ZyntelliTech/Solidyne-SAM-BBG/layouts/Screenshot 2026-08-22 121604.png

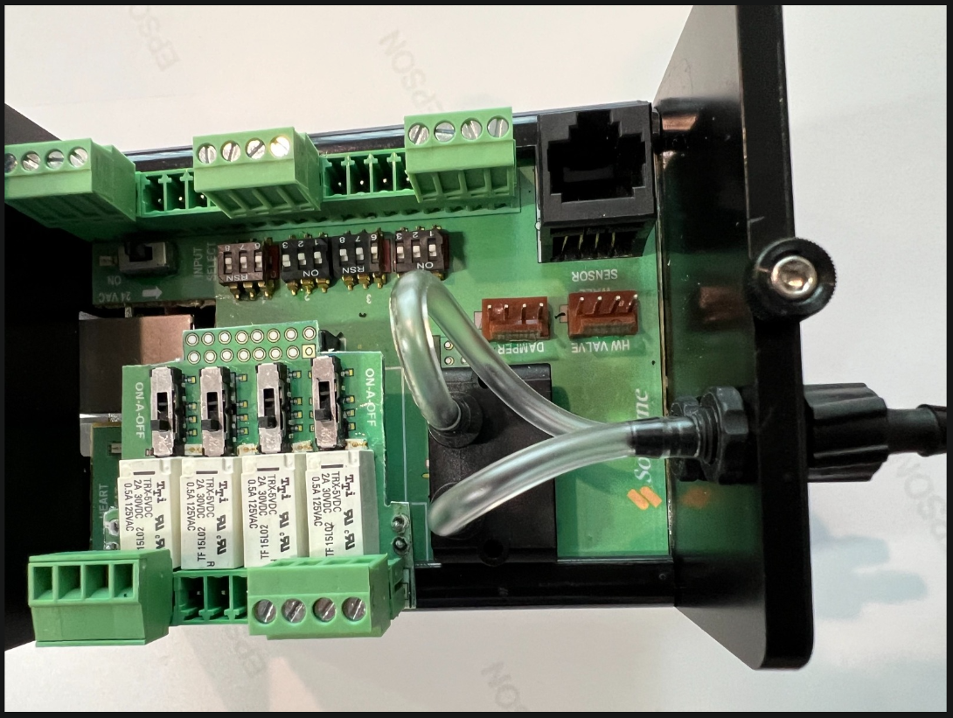
layouts/Screenshot 2026-08-22 121604.png
