ZyntelliTech/Solidyne-SAM-BBG/layouts/comment from Baha 9-17-2026.pdf

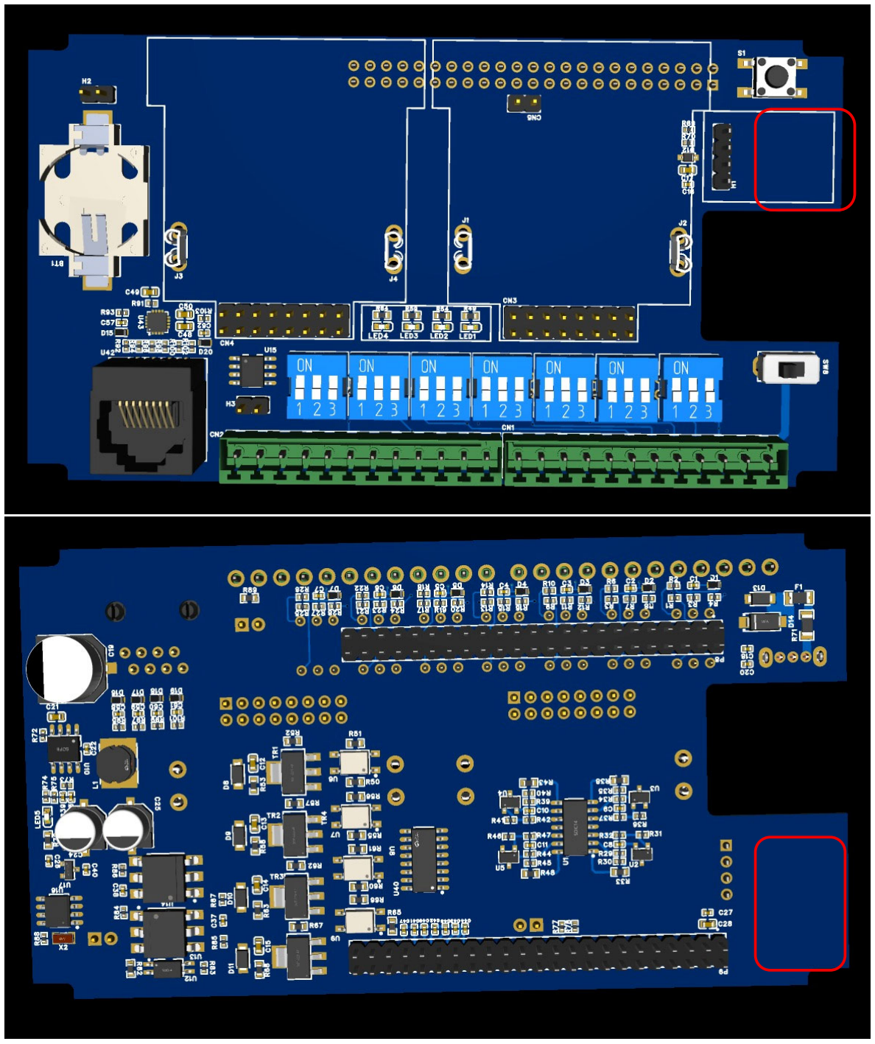
[picture p3: figure]
