ZyntelliTech/Solidyne-SAM-BBG/image/SAM-25-REV.png

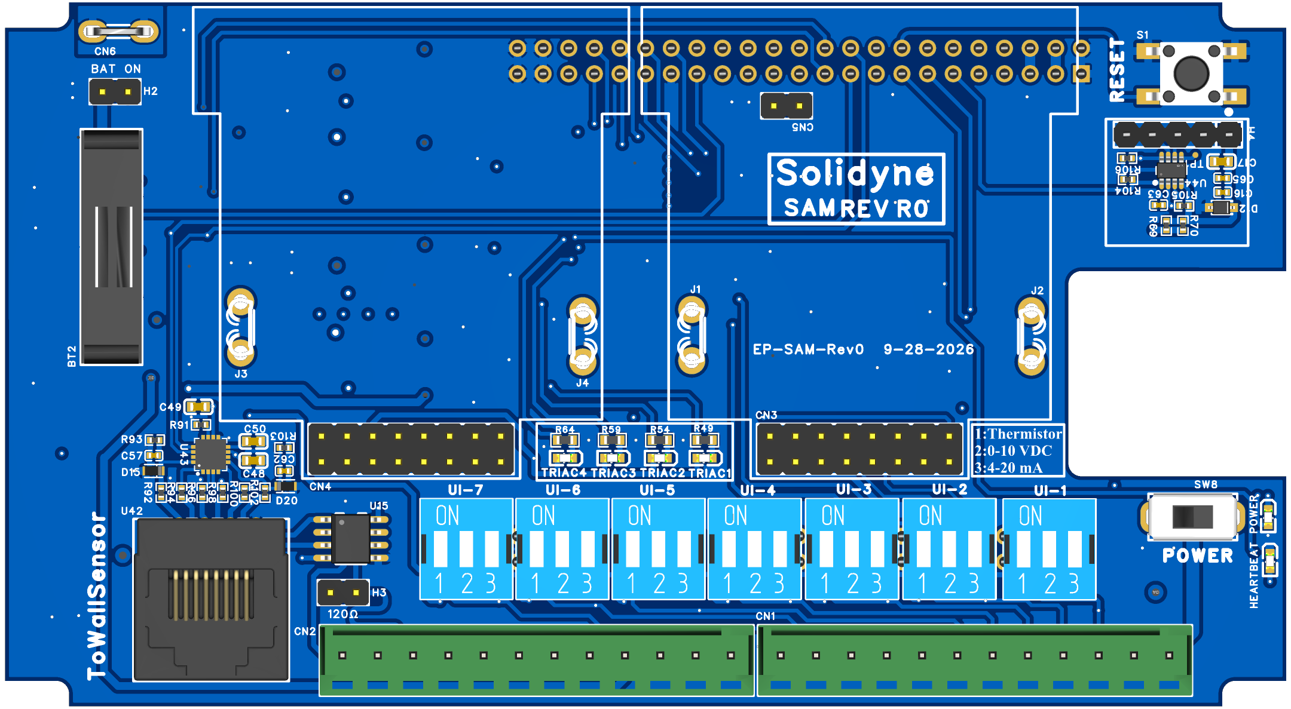
image/SAM-25-REV.png
