ZyntelliTech/Solidyne-SAM-BBG/image/SAM-VAV.png

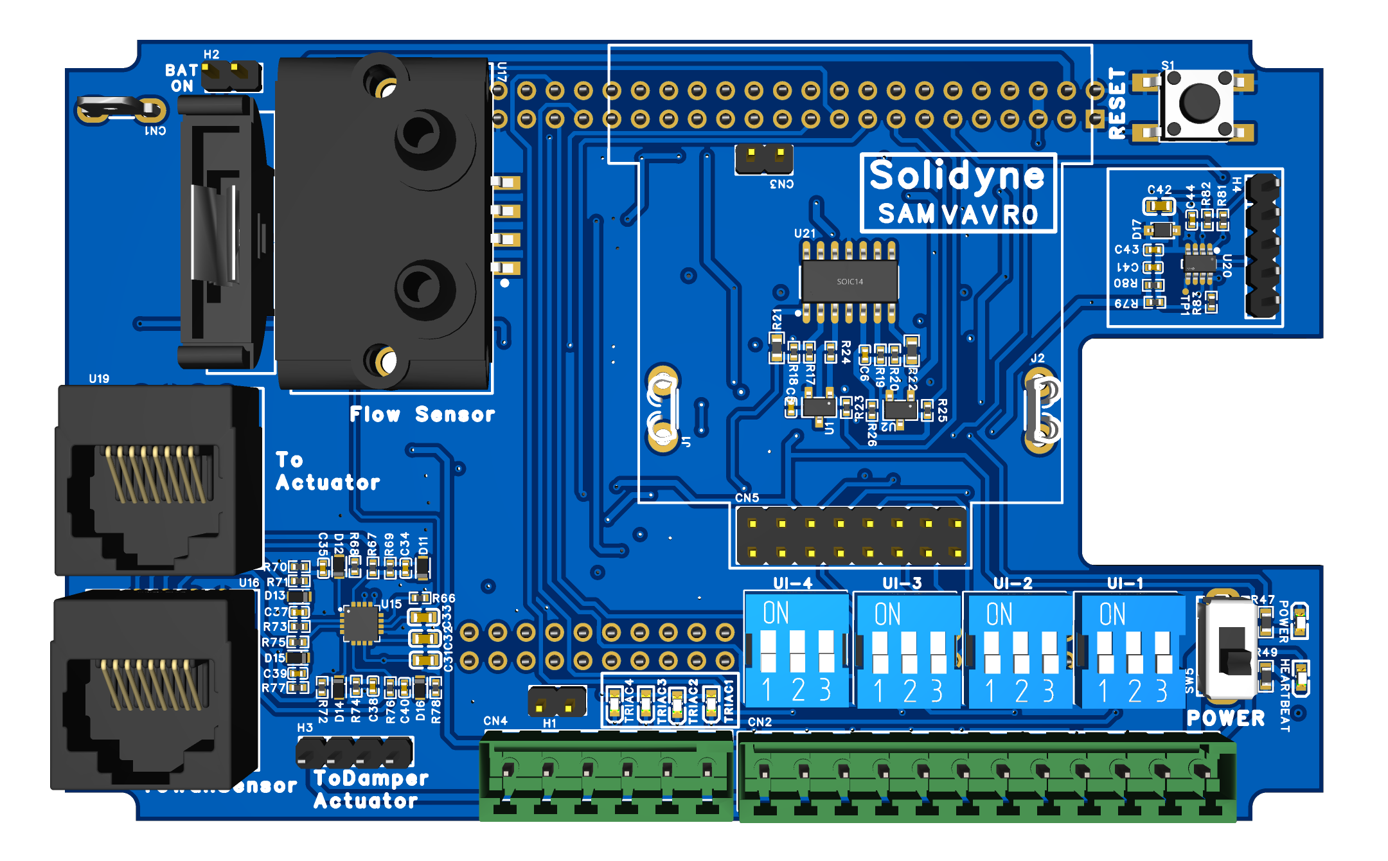
image/SAM-VAV.png
