ZyntelliTech/Solidyne-SAM-BBG/layouts/SAM-25-1.jpeg

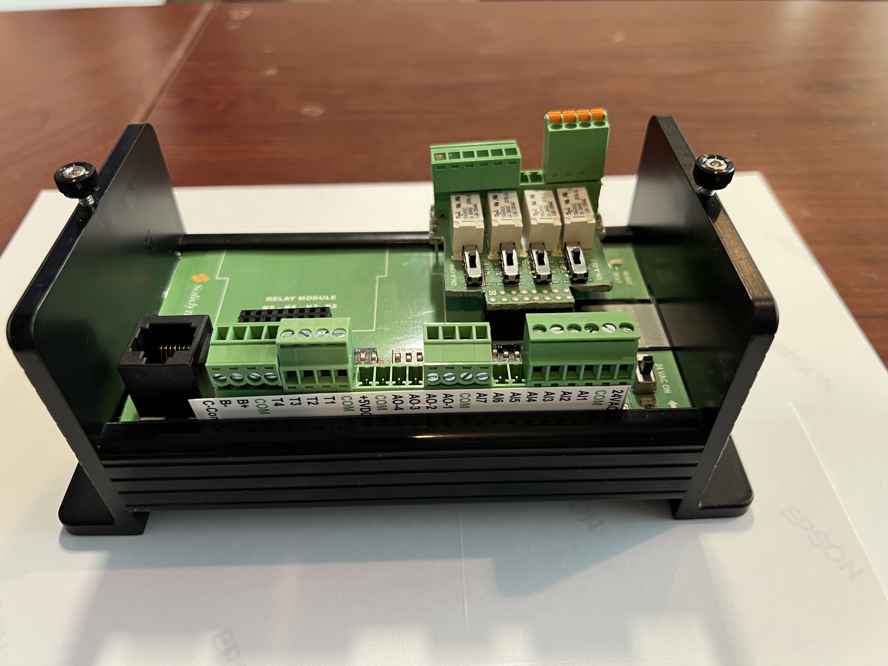
layouts/SAM-25-1.jpeg
