ZyntelliTech/Solidyne-SAM-BBG/layouts/SAM-25-2.jpeg

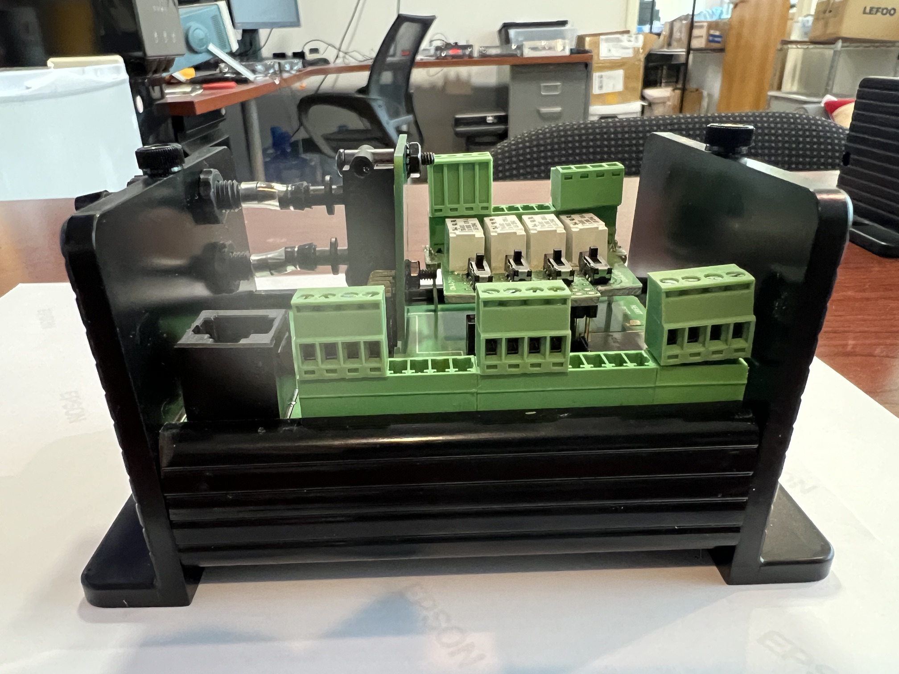
layouts/SAM-25-2.jpeg
