ZyntelliTech/Solidyne-SAM-BBG/layouts/SAM-25.png

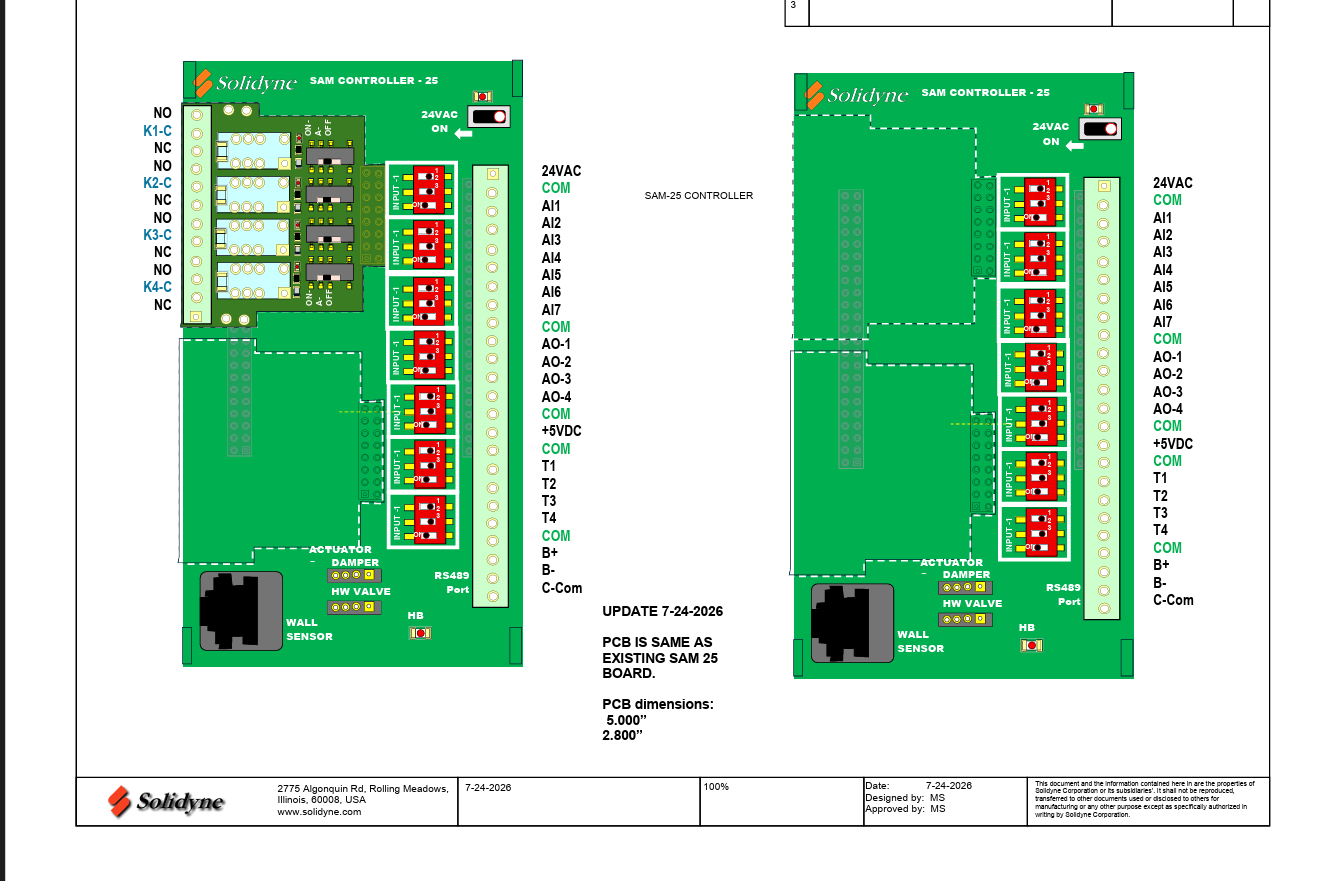
layouts/SAM-25.png
