ZyntelliTech/Solidyne-SAM-BBG/layouts/SAM-VAV-1.jpeg

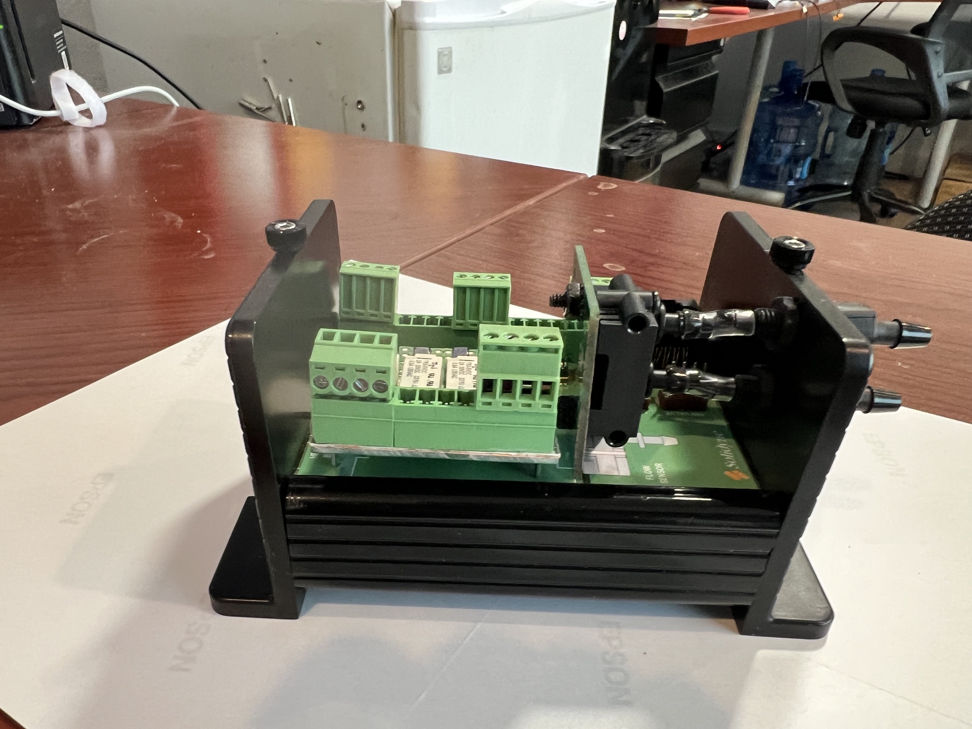
layouts/SAM-VAV-1.jpeg
