ZyntelliTech/Solidyne-SAM-BBG/layouts/SAM-VAV-2.jpeg

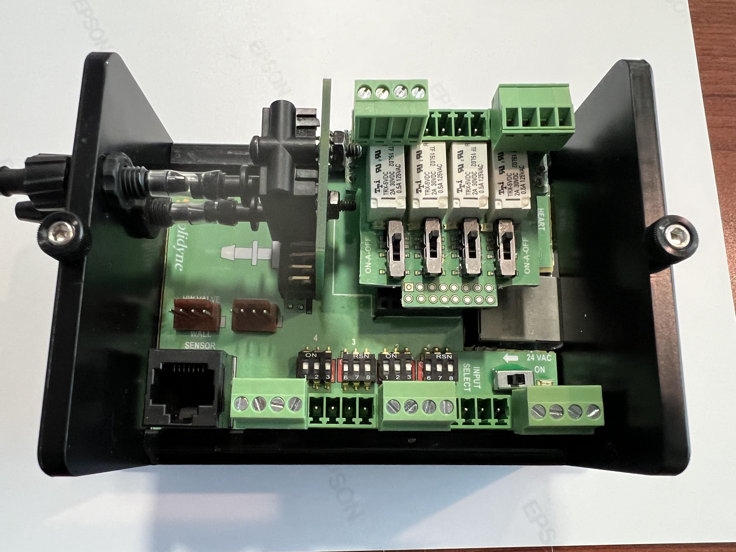
layouts/SAM-VAV-2.jpeg
