ZyntelliTech/Solidyne-SAM-BBG/layouts/SAM-VAV-3.jpeg

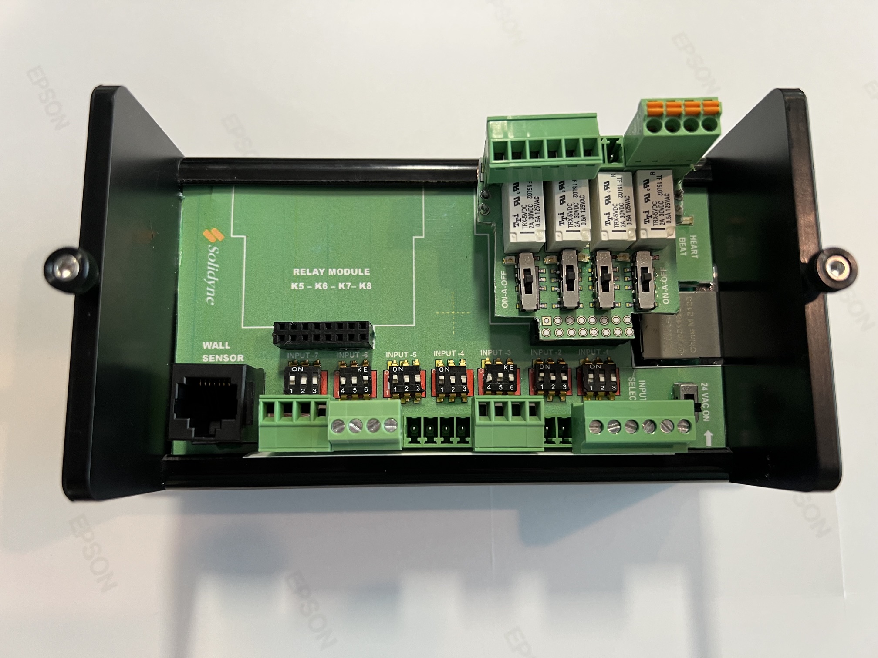
layouts/SAM-VAV-3.jpeg
