ZyntelliTech/Solidyne-SAM-BBG/layouts/SAM_VAV.png

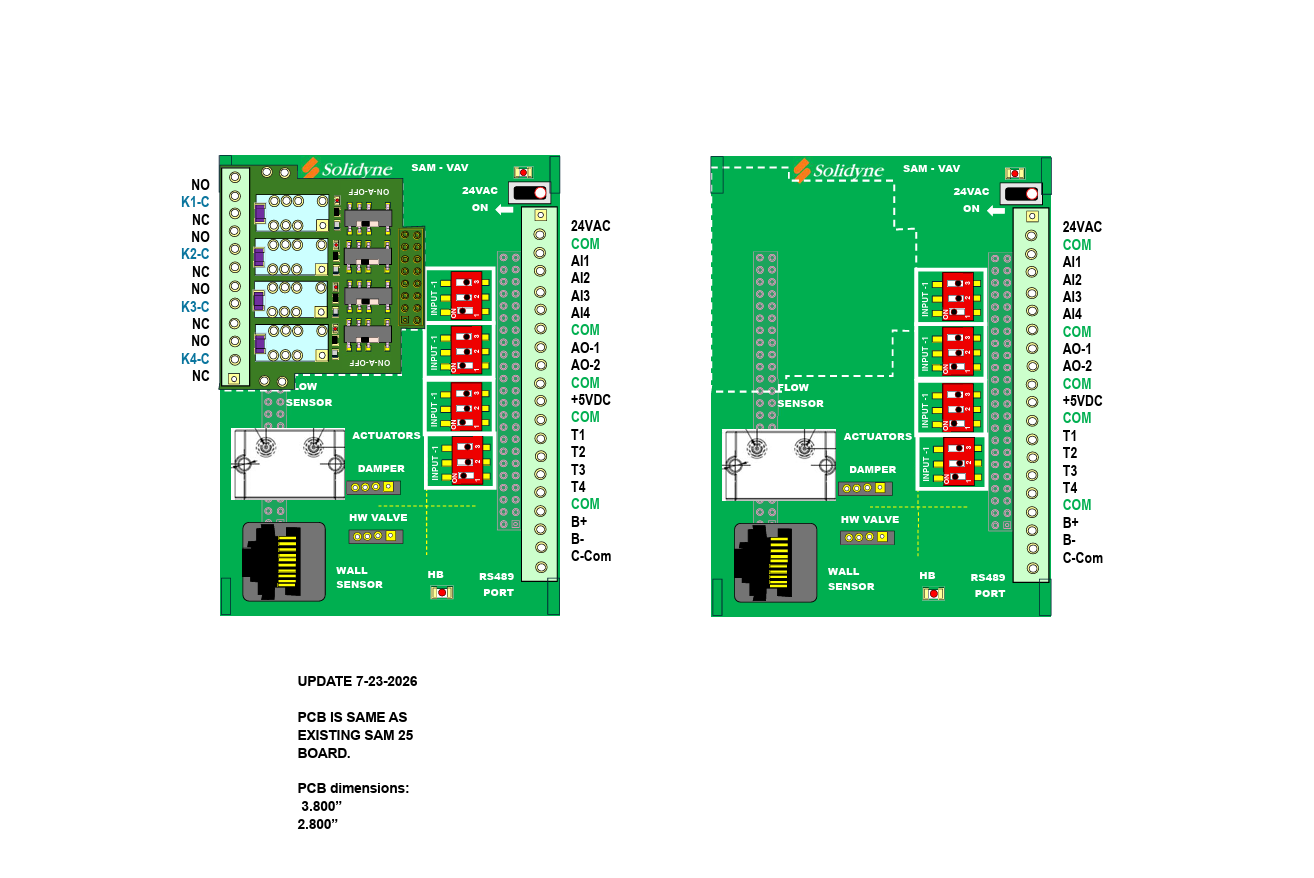
layouts/SAM_VAV.png
