ZyntelliTech/Solidyne-SAM-BBG/layouts/Screenshot 2026-08-22 121533.png

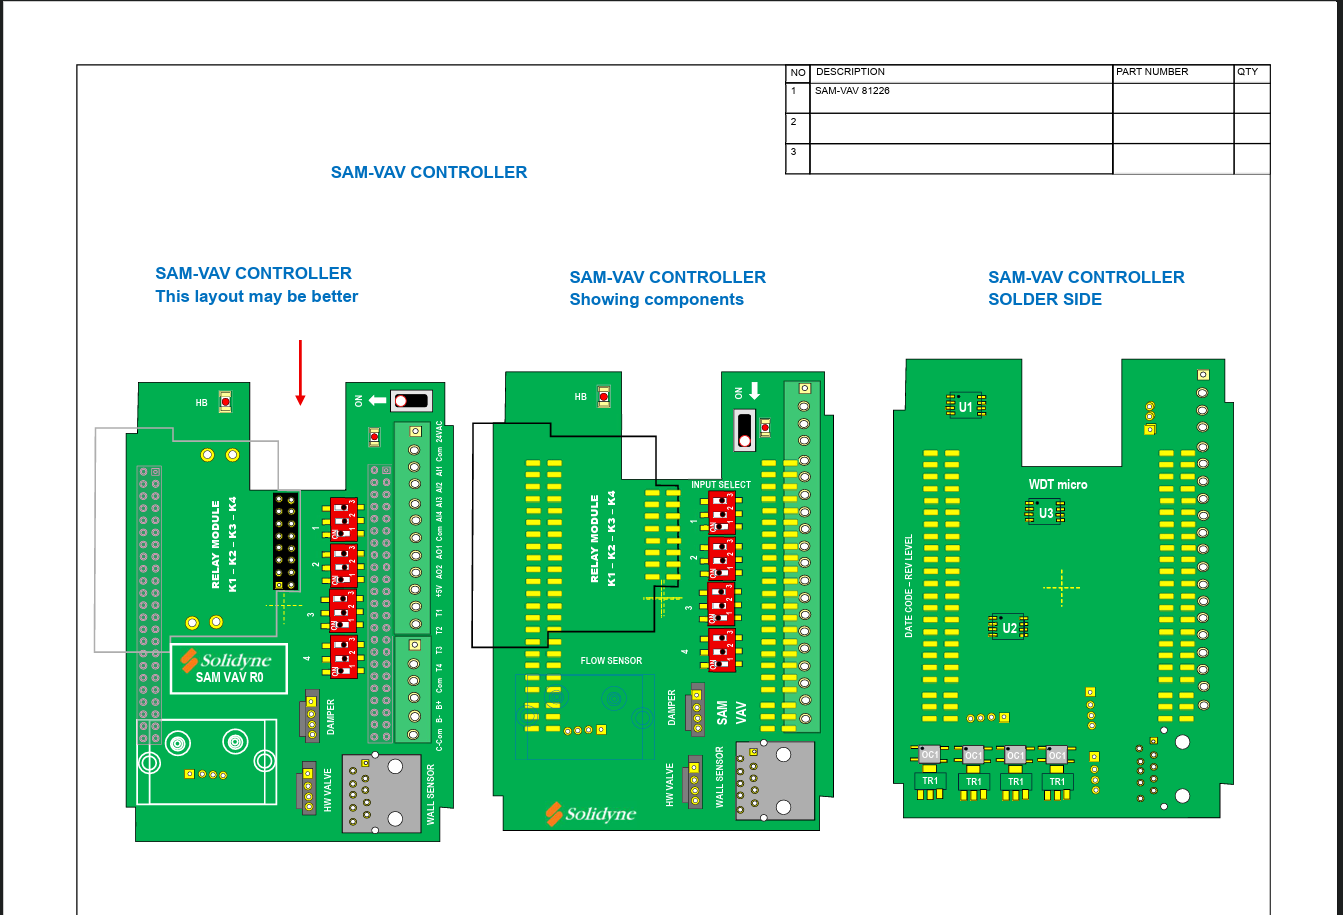
layouts/Screenshot 2026-08-22 121533.png
