ZyntelliTech/Solidyne-SAM-BBG/layouts/Screenshot 2026-08-22 121612.png

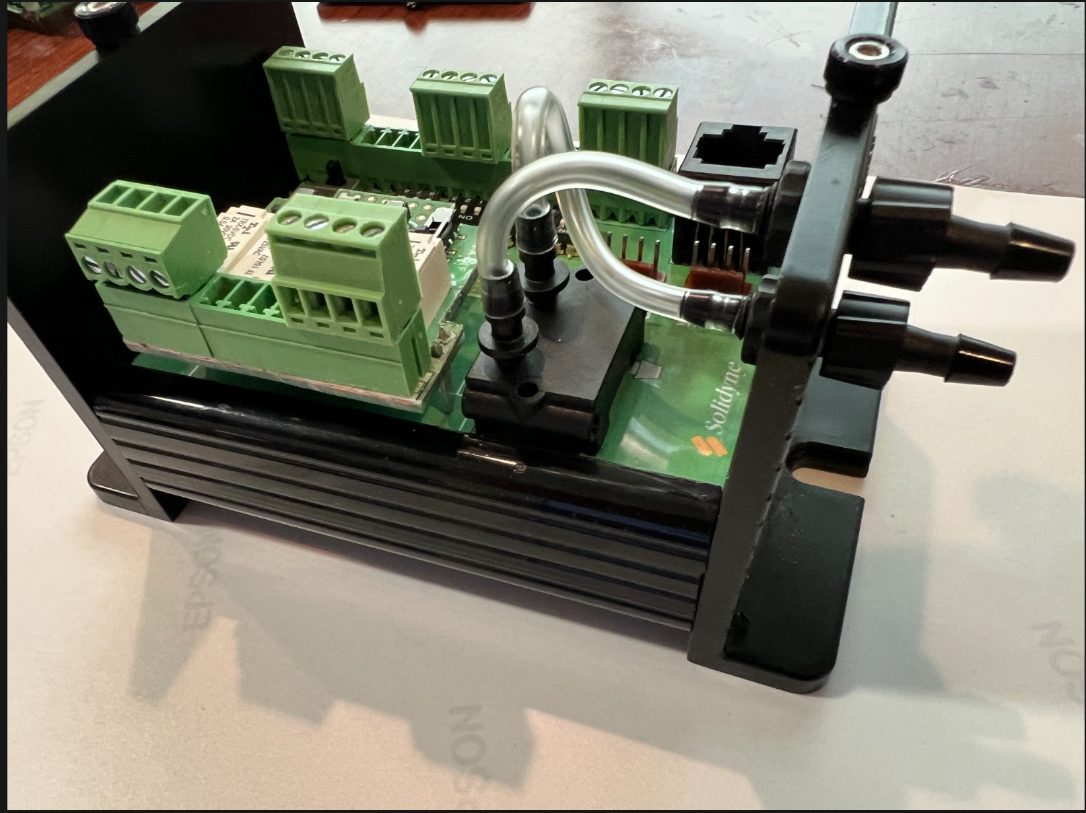
layouts/Screenshot 2026-08-22 121612.png
