ZyntelliTech/Solidyne-SAM-BBG/WDT_SAM_Kicad/WDT_SAM_bom.xlsx

Comment | Designator | Footprint | JLCPCB Part #（optional）
100nF | C1,C3 | Capacitor_SMD:C_0603_1608Metric_Pad1.08x0.95mm_HandSolder | C1590
2.2uF | C2 | Capacitor_SMD:C_0603_1608Metric_Pad1.08x0.95mm_HandSolder | C43922
Conn_01x04_Pin | J1 | Connector_PinHeader_2.54mm:PinHeader_1x04_P2.54mm_Vertical
Conn_01x05_Pin | J2 | Connector_PinHeader_2.54mm:PinHeader_1x05_P2.54mm_Vertical_SMD_Pin1Left | C5160788
33K | R1,R2,R3 | Resistor_SMD:R_0603_1608Metric_Pad0.98x0.95mm_HandSolder | C4216
TestPoint | TP1 | TestPoint:TestPoint_Pad_1.0x1.0mm
MSPM0C1103SDDFR | U2 | footprints:DDF0008A-IPC_A | C35962001
