ZyntelliTech/Solidyne-SAM-BBG/Fab/Relay/BOM_Relay_RelayPCB.xlsx

No. | Quantity | Comment | Designator | Footprint | Value | Manufacturer Part | Manufacturer | Supplier Part | Supplier
1 | 2 | G480-08-2T | CN2,CN3 | TH-2_L6.4-W0.8-P5.08 |  | G480-08-2T | SAMZO(三佐) | C39833011 | LCSC
2 | 1 | PZ254V-12-16P | CN4 | HDR-TH_16P-P2.54-V-M-R2-C8-S2.54 |  | PZ254V-12-16P | XFCN(兴飞) | C492425 | LCSC
3 | 4 | SMAJ60CA | D1,D2,D3,D4 | SMA_L4.4-W2.6-LS5.0-BI |  | SMAJ60CA | Littelfuse(美国力特) | C151247 | LCSC
4 | 4 | G6S-2 DC5 | K1,K2,K3,K4 | RELAY-TH_G6S-2-X |  | G6S-2 DC5 | OMRON(欧姆龙) | C32776 | LCSC
5 | 4 | 204-10SDRD/S530-A3/F182-68 | LED1,LED2,LED3,LED4 | LED-TH_BD4.0-P2.50-RD |  | 204-10SDRD/S530-A3/F182-68 | EVERLIGHT(亿光) | C473831 | LCSC
6 | 4 | 470Ω | R1,R2,R3,R4 | R0402 | 470Ω | RC0402JR-07470RL | YAGEO(国巨) | C114949 | LCSC
7 | 4 | MSS23C02G2-KC 125 | SW1,SW2,SW3,SW4 | SW-SMD_MSS23C02G2-KC |  | MSS23C02G2-KC 125 | SHOU HAN(首韩) | C2858292 | LCSC
8 | 1 | KF2EDGV-3.5-12P | TB-1 | CONN-TH_12P-P3.50_KF2EDGV-3.5-12P |  | KF2EDGV-3.5-12P | KEFA(科发) | C441319 | LCSC
9 | 4 | CDBU00340-HF | U1,U2,U3,U4 | SOD-523F_L1.7-W0.9-LS1.7-RD |  | CDBU00340-HF | Comchip(典琦) | C2886021 | LCSC
10 | 1 | ULN2003ADR | U5 | SOIC-16_L9.9-W3.9-P1.27-LS6.0-BL |  | ULN2003ADR | TI(德州仪器) | C7512 | LCSC
