ZyntelliTech/Solidyne-SAM-BBG/Fab/SAM-VAV/BOM_SAM-VAV_PCB.xlsx

No. | Quantity | Comment | Designator | Footprint | Value | Manufacturer Part | Manufacturer | Supplier Part | Supplier
1 | 1 | BS-05-A1BJ001 | BT1 | BAT-TH_BS-05-A1BJ001 |  | BS-05-A1BJ001 | MYOUNG(美阳) | C964752 | LCSC
2 | 24 | 100nF | C1,C2,C3,C4,C11,C14,C19,C22,C24,C25,C26,C27,C28,C29,C30,C34,C35,C36,C37,C38,C39,C40,C41,C44 | C0402 | 100nF | CL05B104KB54PNC | SAMSUNG(三星) | C307331 | LCSC
3 | 2 | 10uF | C5,C6 | C0402 | 10uF | CL05A106MP5NUNC | SAMSUNG(三星) | C315248 | LCSC
4 | 4 | 10nF | C7,C8,C9,C10 | C0603 | 10nF | CC0603JRX7R9BB103 | YAGEO(国巨) | C115056 | LCSC
5 | 1 | 220nF | C12 | C0402 | 220nF | GRM155R61H224KE01D | muRata(村田) | C5159775 | LCSC
6 | 1 | 330uF | C13 | CAP-SMD_BD10.0-L10.3-W10.3-LS11.3-FD | 330uF | RVT1H331M1010 | ROQANG(容强) | C3032175 | LCSC
7 | 5 | 1uF | C15,C31,C32,C33,C42 | C0603 | 1uF | CL10A105KB8NNNC | SAMSUNG(三星) | C15849 | LCSC
8 | 1 | 47pF | C16 | C0402 | 47pF | 0402CG470J500NT | FH(风华) | C1567 | LCSC
9 | 2 | 220uF | C17,C18 | CAP-SMD_BD6.3-L6.6-W6.6-FD | 220uF | RVT1A221M0605 | ROQANG(容强) | C72494 | LCSC
10 | 1 | 3.3nF | C20 | C0402 | 3.3nF | CC0402KRX7R9BB332 | YAGEO(国巨) | C107028 | LCSC
11 | 2 | 2.2uF | C21,C43 | C0402 | 2.2uF | CL05A225MQ5NSNC | SAMSUNG(三星) | C12530 | LCSC
12 | 1 | 10uF | C23 | C0603 | 10uF | CL10A106KP8NNNC | SAMSUNG(三星) | C19702 | LCSC
13 | 1 | G480-08-2T | CN1 | TH-2_L6.4-W0.8-P5.08 |  | G480-08-2T | SAMZO(三佐) | C39833011 | LCSC
14 | 1 | KF2EDGV-3.5-12P | CN2 | CONN-TH_12P-P3.50_KF2EDGV-3.5-12P |  | KF2EDGV-3.5-12P | KEFA(科发) | C441319 | LCSC
15 | 1 | JP2 | CN3 | HDR-TH_2P-P2.54-V-M |  | JP2 | XFCN(兴飞) | C492401 | LCSC
16 | 1 | KF2EDGV-3.5-6P | CN4 | CONN-TH_6P-P3.50_KF2EDGV-3.5-6P |  | KF2EDGV-3.5-6P | KEFA(科发) | C441325 | LCSC
17 | 1 | PZ254V-12-16P | CN5 | HDR-TH_16P-P2.54-V-M-R2-C8-S2.54 |  | PZ254V-12-16P | XFCN(兴飞) | C492425 | LCSC
18 | 10 | CDBU00340-HF | D1,D2,D3,D4,D11,D12,D13,D14,D15,D16 | SOD-523F_L1.7-W0.9-LS1.7-RD |  | CDBU00340-HF | Comchip(典琦) | C2886021 | LCSC
19 | 5 | SMF60CA | D5,D6,D7,D8,D10 | SOD-123FL_L2.8-W1.8-LS3.7-BI |  | SMF60CA | R+O(宏嘉诚) | C41376092 | LCSC
20 | 1 | ES1B-13-F | D9 | SMA_L4.4-W2.8-LS5.4-RD |  | ES1B-13-F | DIODES(美台) | C106868 | LCSC
21 | 1 | MM3Z3V3ST1G | D17 | SOD-323_L1.7-W1.3-LS2.5-RD |  | MM3Z3V3ST1G | onsemi(安森美) | C182011 | LCSC
22 | 1 | 0466.500NRHF | F1 | F1206 |  | 0466.500NRHF | Littelfuse(美国力特) | C151133 | LCSC
23 | 2 | PZ254V-11-02P | H1,H2 | HDR-TH_2P-P2.54-V-M |  | PZ254V-11-02P | XFCN(兴飞) | C492401 | LCSC
24 | 1 | TEMP SENSOR | H3 | HDR-TH_4P-P2.54-V-M |  | TEMP SENSOR | XFCN(兴飞) | C2691448 | LCSC
25 | 1 | PZ254V-11-05P | H4 | HDR-TH_5P-P2.54-V-M |  | PZ254V-11-05P | XFCN(兴飞) | C492404 | LCSC
26 | 6 | KT-0603R | HEARTBEAT,POWER,TRIAC1,TRIAC2,TRIAC3,TRIAC4 | LED-SMD_L1.6-W0.8-R-RD |  | KT-0603R | KENTO | C2286 | LCSC
27 | 2 | 3551 | J1,J2 | CONN-TH_3551 |  | 3551 | Keystone | C238112 | LCSC
28 | 1 | 6.8uH | L1 | IND-SMD_L5.8-W5.2 | 6.8uH | CY54-6.8UH | SHOU HAN(首韩) | C2929430 | LCSC
29 | 2 | X6521WV-2x23H-C60D30 | P8,P9 | HDR-TH_46P-2.54-V-M-R2-C23-S2.54 |  | X6521WV-2x23H-C60D30 | XKB Connection(中国星坤) | C725895 | LCSC
30 | 16 | 10kΩ | R1,R2,R5,R6,R9,R10,R13,R14,R17,R19,R67,R68,R71,R72,R75,R76 | R0402 | 10kΩ | 0402WGF1002TCE | UNI-ROYAL(厚声) | C25744 | LCSC
31 | 4 | 90.9Ω | R4,R8,R12,R16 | R0402 | 90.9Ω | 0402WGF909JTCE | UNI-ROYAL(厚声) | C129693 | LCSC
32 | 2 | 71.5kΩ | R18,R20 | R0402 | 71.5kΩ | RT0402BRD0771K5L | YAGEO(国巨) | C852906 | LCSC
33 | 2 | 50Ω | R21,R22 | R0603 | 50Ω | RT0603BRE0750RL | YAGEO(国巨) | C849792 | LCSC
34 | 9 | 1kΩ | R23,R25,R57,R58,R59,R61,R63,R64,R65 | R0402 | 1kΩ | 0402WGF1001TCE | UNI-ROYAL(厚声) | C11702 | LCSC
35 | 3 | 100kΩ | R24,R26,R66 | R0402 | 100kΩ | 0402WGF1003TCE | UNI-ROYAL(厚声) | C25741 | LCSC
36 | 4 | 330Ω | R27,R28,R37,R38 | R0603 | 330Ω | 0603WAF3300T5E | UNI-ROYAL(厚声) | C23138 | LCSC
37 | 7 | 470Ω | R29,R30,R39,R40,R47,R49,R56 | R0603 | 470Ω | 0603WAF4700T5E | UNI-ROYAL(厚声) | C23179 | LCSC
38 | 4 | 220Ω | R31,R32,R41,R42 | R0603 | 220Ω | 0603WAF2200T5E | UNI-ROYAL(厚声) | C22962 | LCSC
39 | 4 | 1kΩ | R33,R35,R43,R45 | R0603 | 1kΩ | 0603WAF1001T5E | UNI-ROYAL(厚声) | C21190 | LCSC
40 | 4 | 100Ω | R34,R36,R44,R46 | R0603 | 100Ω | 0603WAF1000T5E | UNI-ROYAL(厚声) | C22775 | LCSC
41 | 1 | 0Ω | R48 | R1206 | 0Ω | 1206W4F0000T5E | UNI-ROYAL(厚声) | C17888 | LCSC
42 | 1 | 115kΩ | R50 | R0402 | 115kΩ | RC0402FR-07115KL | YAGEO(国巨) | C273341 | LCSC
43 | 1 | 14kΩ | R51 | R0402 | 14kΩ | RC0402FR-0714KL | YAGEO(国巨) | C327372 | LCSC
44 | 1 | 200kΩ | R52 | R0402 | 200kΩ | 0402WGF2003TCE | UNI-ROYAL(厚声) | C25764 | LCSC
45 | 1 | 22kΩ | R53 | R0402 | 22kΩ | 0402WGF2202TCE | UNI-ROYAL(厚声) | C25768 | LCSC
46 | 9 | 4.7kΩ | R54,R55,R62,R69,R70,R73,R74,R77,R78 | R0402 | 4.7kΩ | 0402WGF4701TCE | UNI-ROYAL(厚声) | C25900 | LCSC
47 | 1 | 120Ω | R60 | R0603 | 120Ω | 0603WAF1200T5E | UNI-ROYAL(厚声) | C22787 | LCSC
48 | 2 | 6.8kΩ | R79,R80 | R0402 | 6.8kΩ | RC0402FR-076K8L | YAGEO(国巨) | C93940 | LCSC
49 | 3 | 33kΩ | R81,R82,R83 | R0402 | 33kΩ | FRC0402F3302TS | FOJAN(富捷) | C2909350 | LCSC
50 | 4 | 2.2kΩ | R162,R163,R164,R165 | R0402 | 2.2kΩ | 0402WGF2201TCE | UNI-ROYAL(厚声) | C25879 | LCSC
51 | 1 | RESET | S1 | KEY-SMD_4P-L6.0-W6.0-P4.50-LS8.6 |  | RESET | Megastar(兆星) | C7470153 | LCSC
52 | 1 | SS12D07VG4 087 | SW5 | SW-TH_SS12D07VG4 |  | SS12D07VG4 087 | SHOU HAN(首韩) | C2939726 | LCSC
53 | 1 | Test-Point | TP1 | Test-Point-0.5mm
54 | 4 | Z0107MN 5AA4 | TR1,TR2,TR3,TR4 | SOT-223_L6.7-W3.5-P2.30-BR |  | Z0107MN 5AA4 | ST(意法半导体) | C71218 | LCSC
55 | 2 | LM4041C12IDBZR | U1,U2 | SOT-23-3_L2.9-W1.6-P1.90-LS2.8-BR |  | LM4041C12IDBZR | TI(德州仪器) | C133587 | LCSC
56 | 4 | CTM3053(T1) | U3,U4,U5,U6 | SOP-4_L3.6-W4.4-P2.54-LS7.0-TL |  | CTM3053(T1) | CT MICRO | C453470 | LCSC
57 | 1 | ULN2003ADR | U7 | SOIC-16_L9.9-W3.9-P1.27-LS6.0-BL |  | ULN2003ADR | TI(德州仪器) | C7512 | LCSC
58 | 1 | AP64350SP-13 | U8 | SO-8_L4.9-W3.9-P1.27-LS6.0-BL-EP |  | AP64350SP-13 | DIODES(美台) | C2071691 | LCSC
59 | 1 | AP7313-18SAG-7 | U9 | SOT-23-3_L2.9-W1.3-P1.90-LS2.4-BR |  | AP7313-18SAG-7 | DIODES(美台) | C460373 | LCSC
60 | 1 | HMHA2801R2 | U10 | SMD-4_L2.7-W4.4-P1.27-LS7.0-BL |  | HMHA2801R2 | onsemi(安森美) | C457670 | LCSC
61 | 2 | H11L1S(TA) | U11,U14 | SMD-6_L7.3-W6.5-P2.54-LS10.2-BL |  | H11L1S(TA) | EVERLIGHT(亿光) | C78589 | LCSC
62 | 1 | SP485EEN-L/TR | U12 | SOIC-8_L5.0-W4.0-P1.27-LS6.0-BL |  | SP485EEN-L/TR | MaxLinear(迈凌) | C6855 | LCSC
63 | 1 | DS1307DTR(XBLW) | U13 | SOP-8_L4.9-W3.9-P1.27-LS6.0-BL |  | DS1307DTR(XBLW) | XBLW(芯伯乐) | C18723598 | LCSC
64 | 1 | TLA2528IRTER | U15 | WQFN-16_L3.0-W3.0-P0.50-TL-EP1.7 |  | TLA2528IRTER | TI(德州仪器) | C2866175 | LCSC
65 | 2 | HC-RJ45-5224-1-6 | U16,U19 | RJ45-TH_HCTL_HC-RJ45-5224-1-6 |  | HC-RJ45-5224-1-6 | HCTL(华灿天禄) | C3010562 | LCSC
66 | 1 | SDP810-500PA | U17 | SENSOR-TH_SDP810-500PA |  | SDP810-500PA | Sensirion(瑞士盛思锐) | C153056 | LCSC
67 | 1 | XGZP6897DC2.5HPDPN | U18 | SMD-8_L11.0-W7.0-P2.54-LS10.8-BL |  | XGZP6897DC2.5HPDPN |  | C9900276660 | LCSC
68 | 1 | MSPM0C1103SDDFR | U20 | TSOT-23-8_L2.9-W1.6-P0.65-LS2.8-BR |  | MSPM0C1103SDDFR | TI(德州仪器) | C35962001 | LCSC
69 | 1 | MC33174DR2G | U21 | SOIC-14_L8.7-W3.9-P1.27-LS6.0-BL |  | MC33174DR2G | onsemi(安森美) | C113552 | LCSC
70 | 4 | SMQS-03R-TP | UI-1,UI-2,UI-3,UI-4 | SW-TH_SMQS-03B-TP |  | SMQS-03R-TP | SM Switch | C5299504 | LCSC
71 | 1 | 32.768kHz | X1 | FC-135R_L3.2-W1.5 | 32.768kHz | Q13FC13500004 | EPSON(爱普生) | C32346 | LCSC
