ZyntelliTech/Solidyne-SAM-BBG/3d/3D_RelayPCB.step

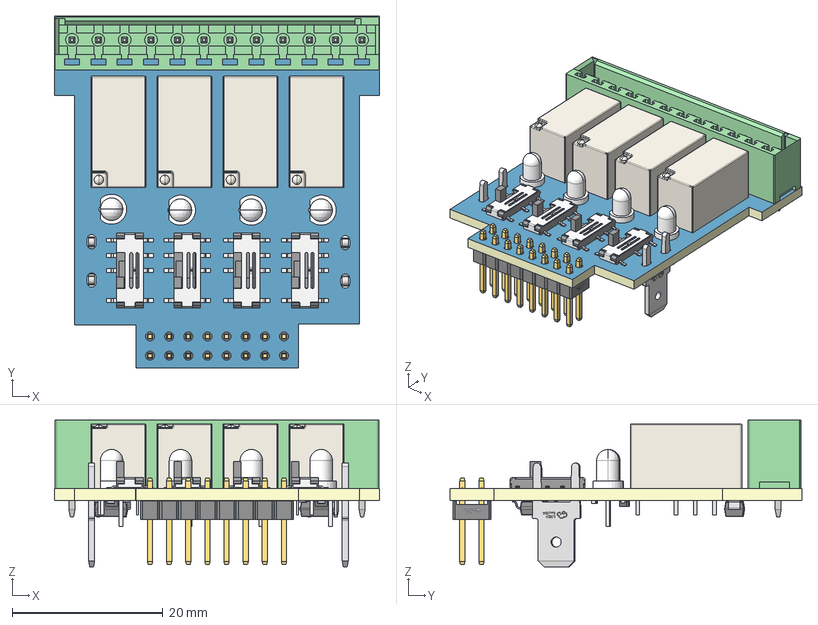
[picture p16: CAD file, 2026-09-18]
3d/3D_RelayPCB.step
43.2 x 46.7 x 19.5 mm
Board~EXx5
TopCopper~EXx5
BottomCopper~EXx5
TopFpcStiffener~EXx5
BottomFpcStiffener~EXx5
R0402~R0402_L1.0-W0.5-H0.4~EXx5 x 4
HDR-TH_16P-P2.54-V-M-R2-C8-S2.54~HDR2.54-M-LI-2X8P~EXx5
TH-2_L6.4-W0.8-P5.08~TH-2_L6.4-W0.8-P5.08~EXx5 x 2
SOD-523F_L1.7-W0.9-LS1.7-RD~SOD-523F_L1.7-W0.9-LS1.7-RD~EXx5 x 4
SW-SMD_MSS23C02G2-KC~SW-SMD_MSS23C02G2-KC~EXx5 x 8
SOIC-16_L9.9-W3.9-P1.27-LS6.0-BL~SOIC-16_ L9.9-W3.9-H1.8-LS6.0-P1.27~EXx5
LED-TH_BD4.0-P2.50-RD~LED-TH_BD4.0-P2.50-H6.0-RD~EXx5 x 4
SMA_L4.4-W2.6-LS5.0-BI~SMA_L4.3-W2.5-H2.1-LS5.0~EXx5 x 4
CONN-TH_12P-P3.50_KF2EDGV-3.5-12P~CONN-TH_12P-P3.50_ KF2EDGV-3.5-12P~EXx5
RELAY-TH_G6S-2-X~RELAY-TH_L14.8-W7.3-H9.2-P2.54~EXx5 x 4
