ZyntelliTech/Solidyne-SAM-BBG/(list of files, cad)

Other CAD files:
3d/3D_SAM_VAV_PCB.step
3d/3D_SAM-25.step
