ZyntelliTech/Solidyne-SAM-BBG/schematic/SCH_RelaySch.pdf

RELAY 1 | RELAY 2 | RELAY 3 | RELAY 4

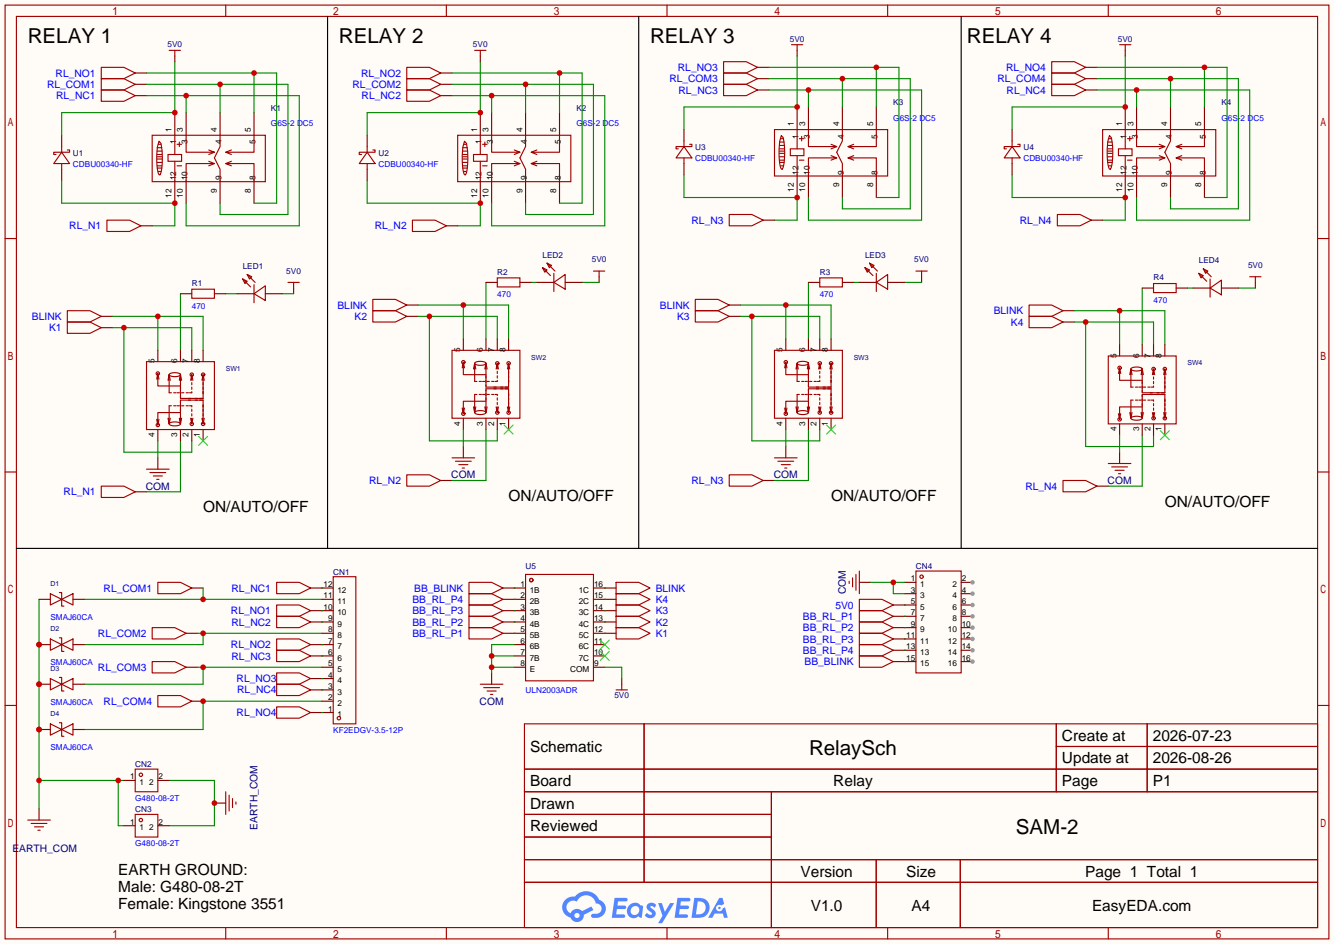
[picture p17: page 1]

Schematic | RelaySch | Create at | 2026-07-23

Update at | 2026-08-26

Board | Relay | Page | P1
Drawn | | SAM-2
Reviewed

Version | Size | Page 1 Total 1
V1.0 | A4 | EasyEDA.com
