ZyntelliTech/Solidyne-SAM-BBG/schematic/SCH_SAMVAV_Schematic.pdf

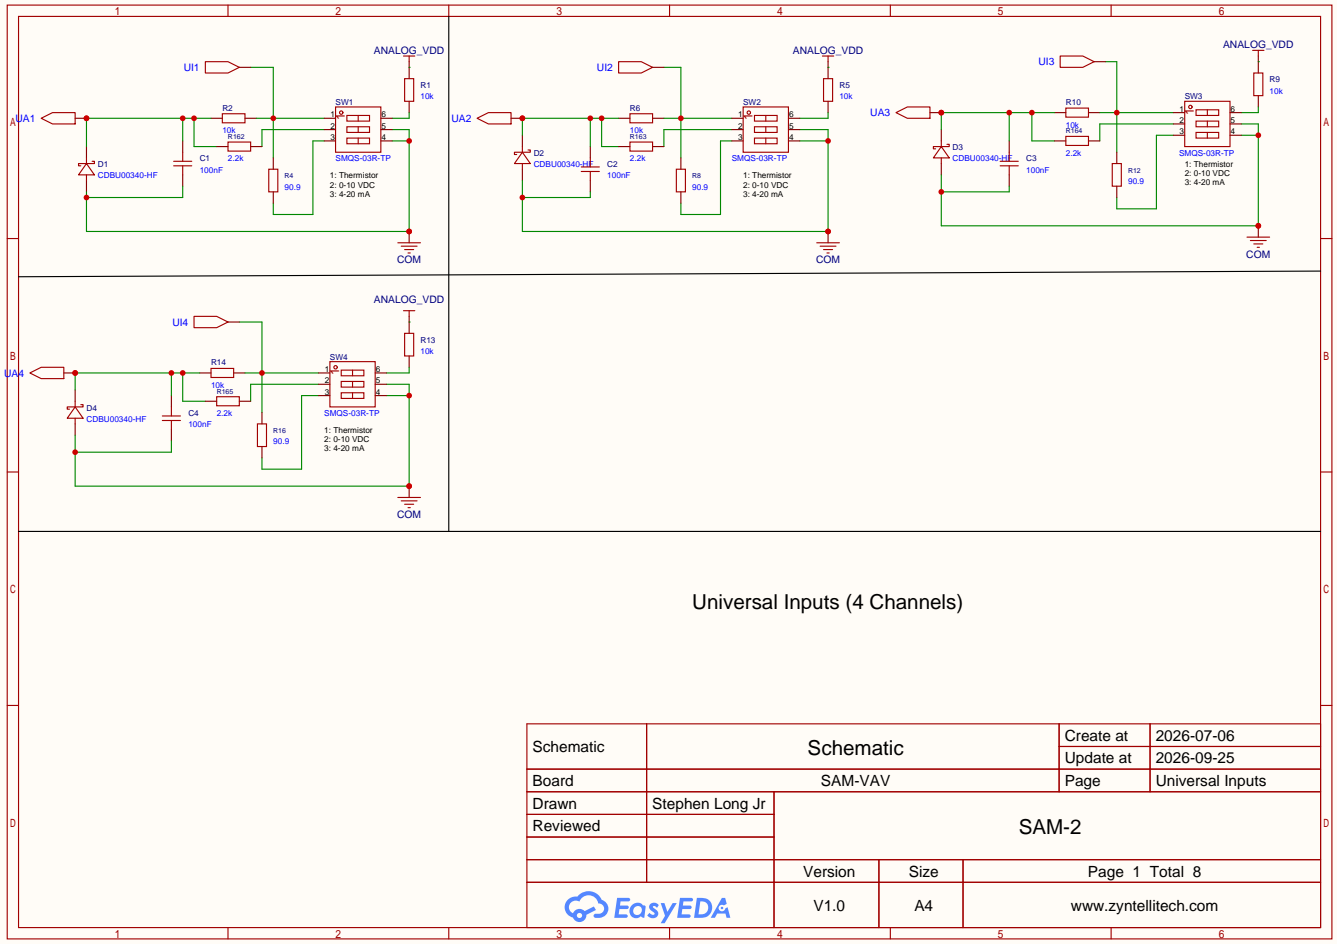
[picture p26: page 1]

Schematic | Schematic | Create at | 2026-07-06

Update at | 2026-09-25

Board | SAM-VAV | Page | Universal Inputs
Drawn | Stephen Long Jr | SAM-2
Reviewed

Version | Size | Page 1 Total 8
V1.0 | A4 | www.zyntellitech.com

Analog Output - 1 | Analog Output - 2

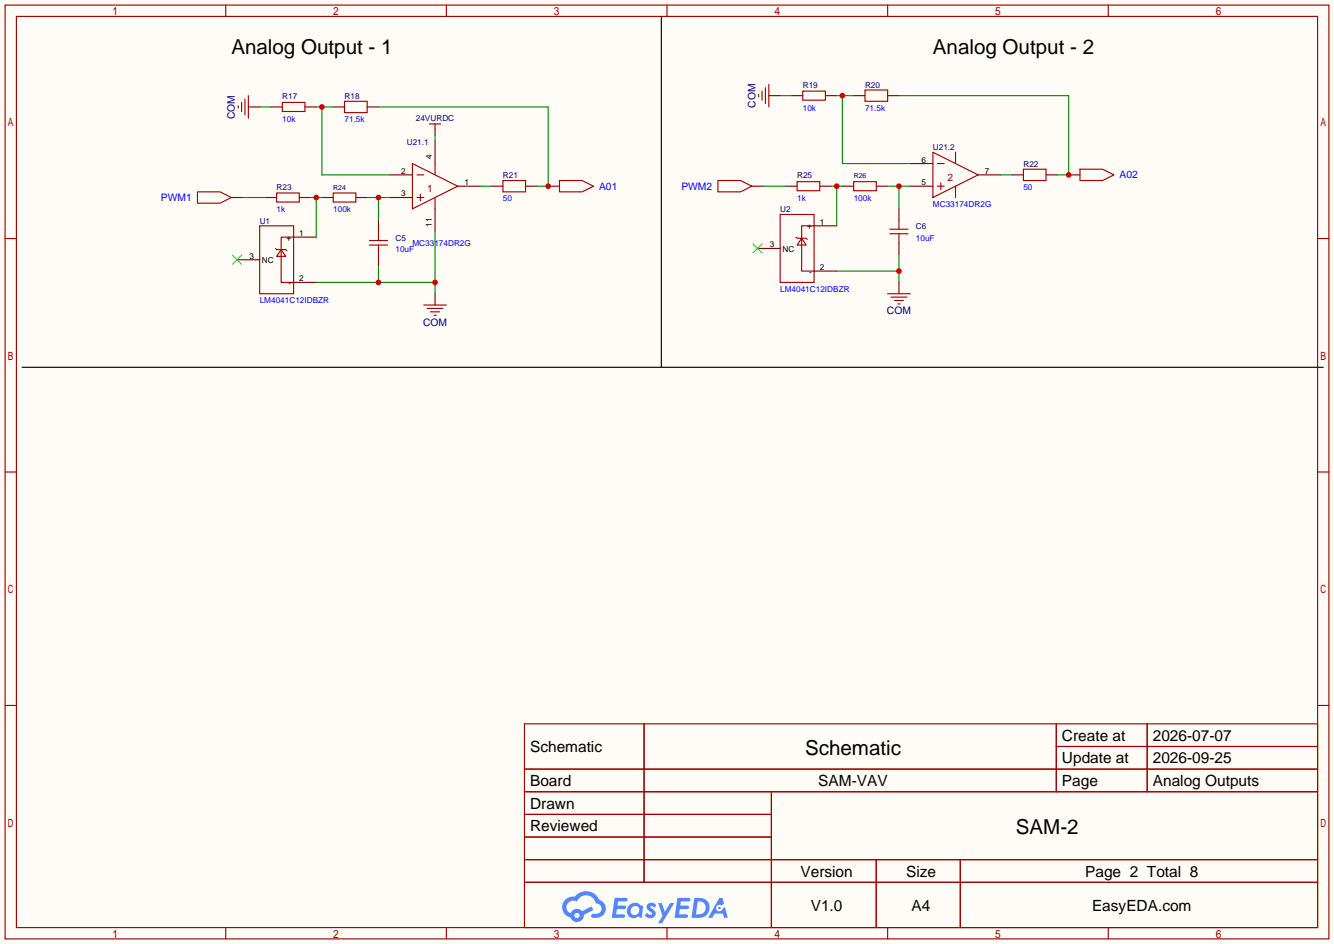
[picture p27: page 2]

Schematic | Schematic | Create at | 2026-07-07

Update at | 2026-09-25

Board | SAM-VAV | Page | Analog Outputs
Drawn | | SAM-2
Reviewed

Version | Size | Page 2 Total 8
V1.0 | A4 | EasyEDA.com

TRIAC - 1 | TRIAC - 2

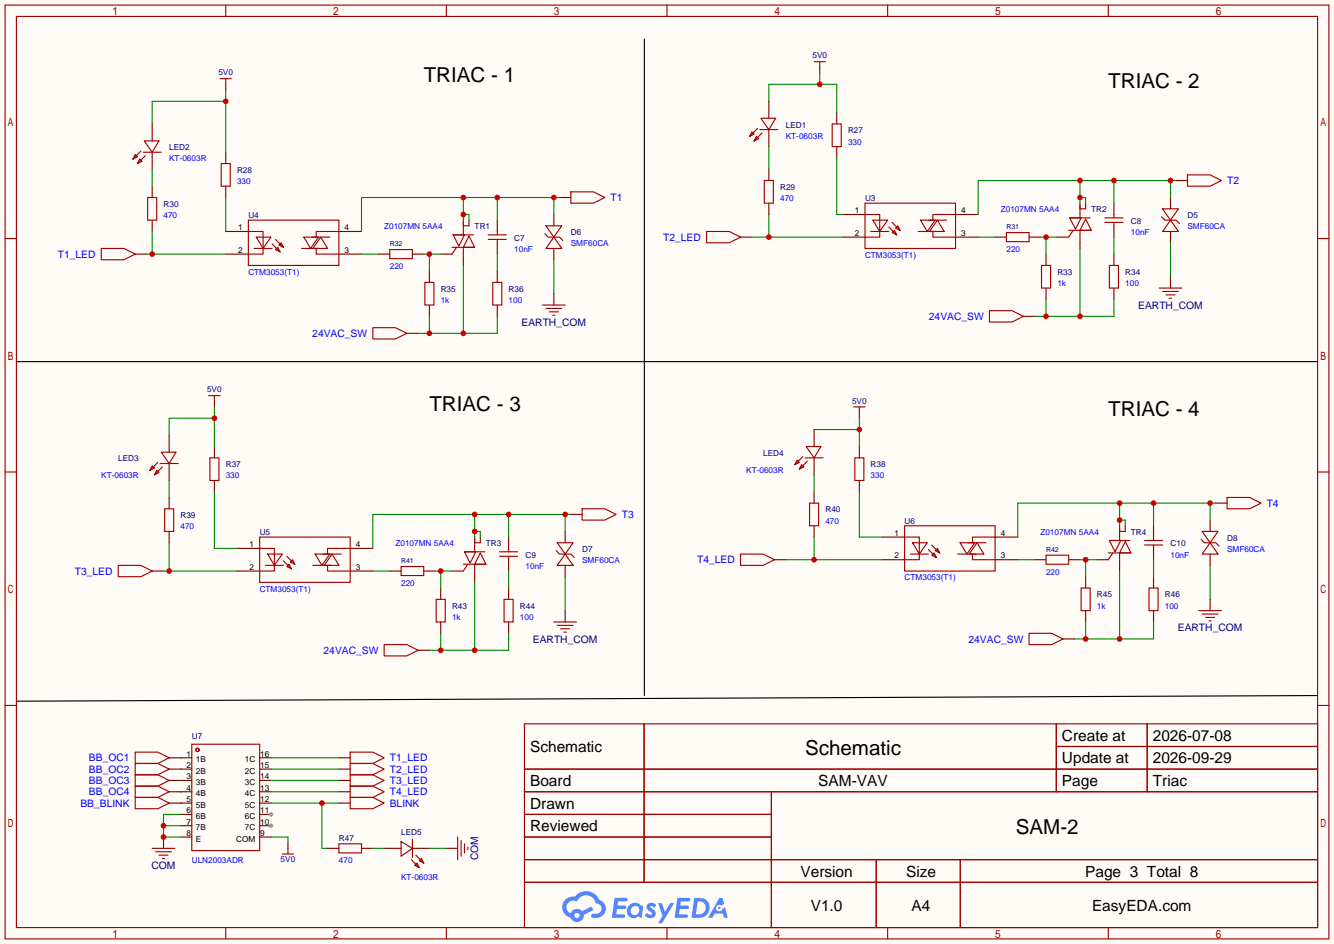
[picture p28: page 3]

Schematic | Schematic | Create at | 2026-07-08

Update at | 2026-09-29

Board | SAM-VAV | Page | Triac
Drawn | | SAM-2
Reviewed

# 24VAC to 5V Power Regulator

# G480-08-2T COM

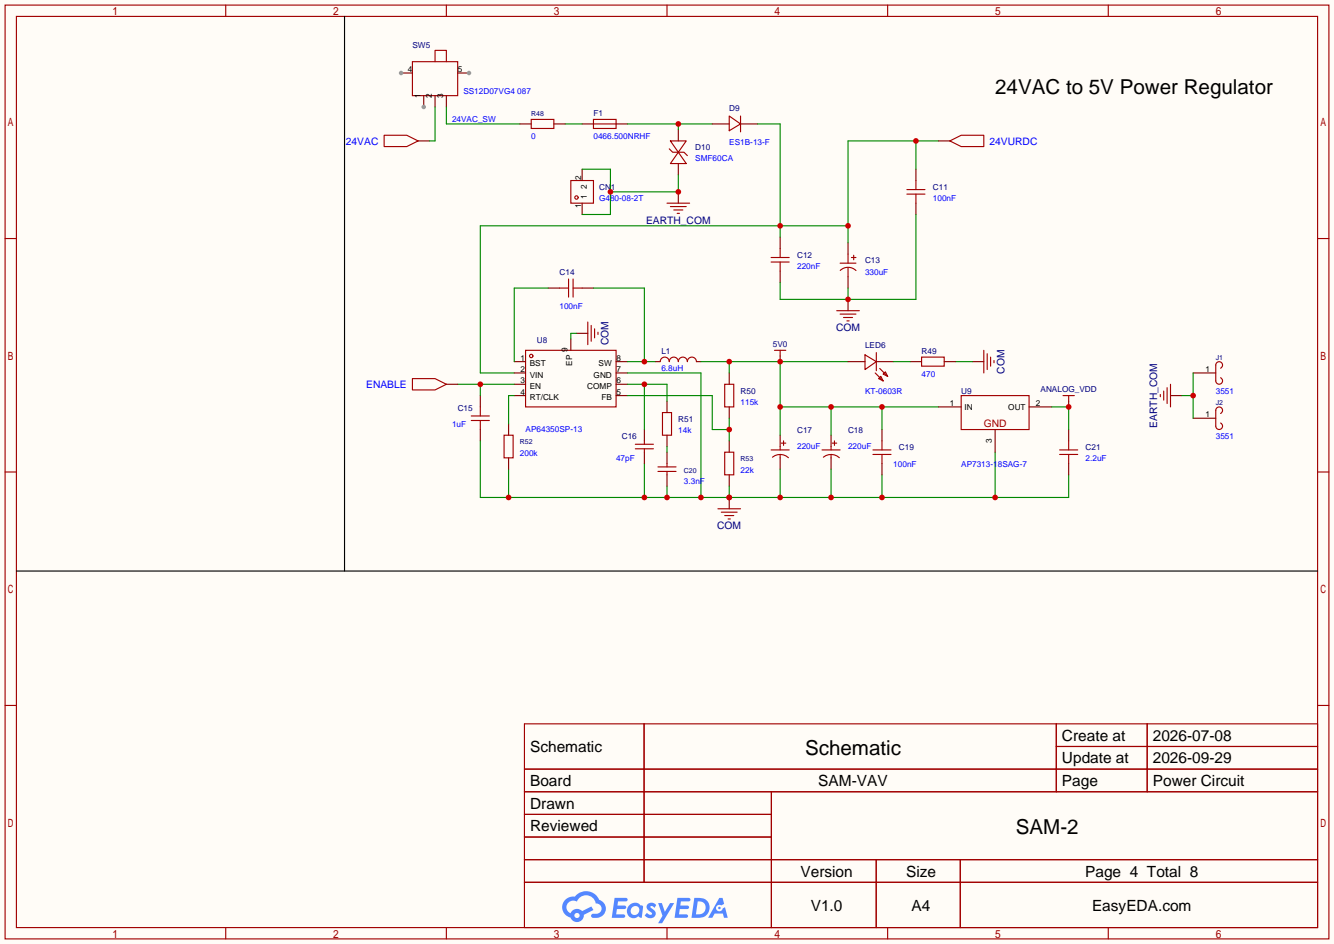
[picture p29: page 4]

Schematic | Schematic | Create at | 2026-07-08

Update at | 2026-09-29

Board | SAM-VAV | Page | Power Circuit
Drawn | | SAM-2
Reviewed

# BeagleBone Connector IO Connectors

# KF2EDGV-3.5-12P 1 1

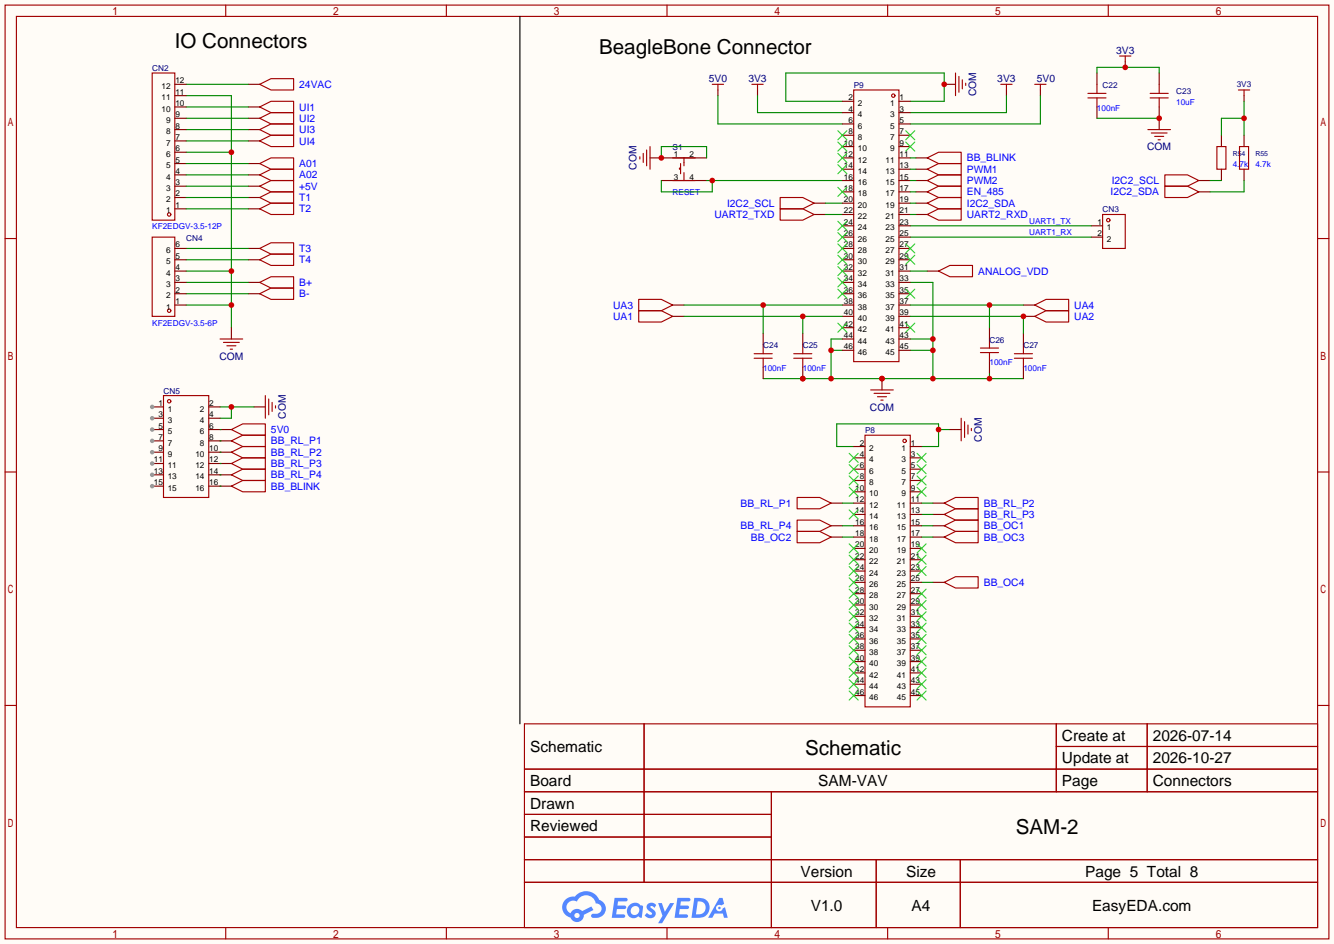
[picture p30: page 5]

Schematic | Schematic | Create at | 2026-07-14

Update at | 2026-10-27

Board | SAM-VAV | Page | Connectors
Drawn | | SAM-2
Reviewed

# RS485 Interface

# Real Time Clock

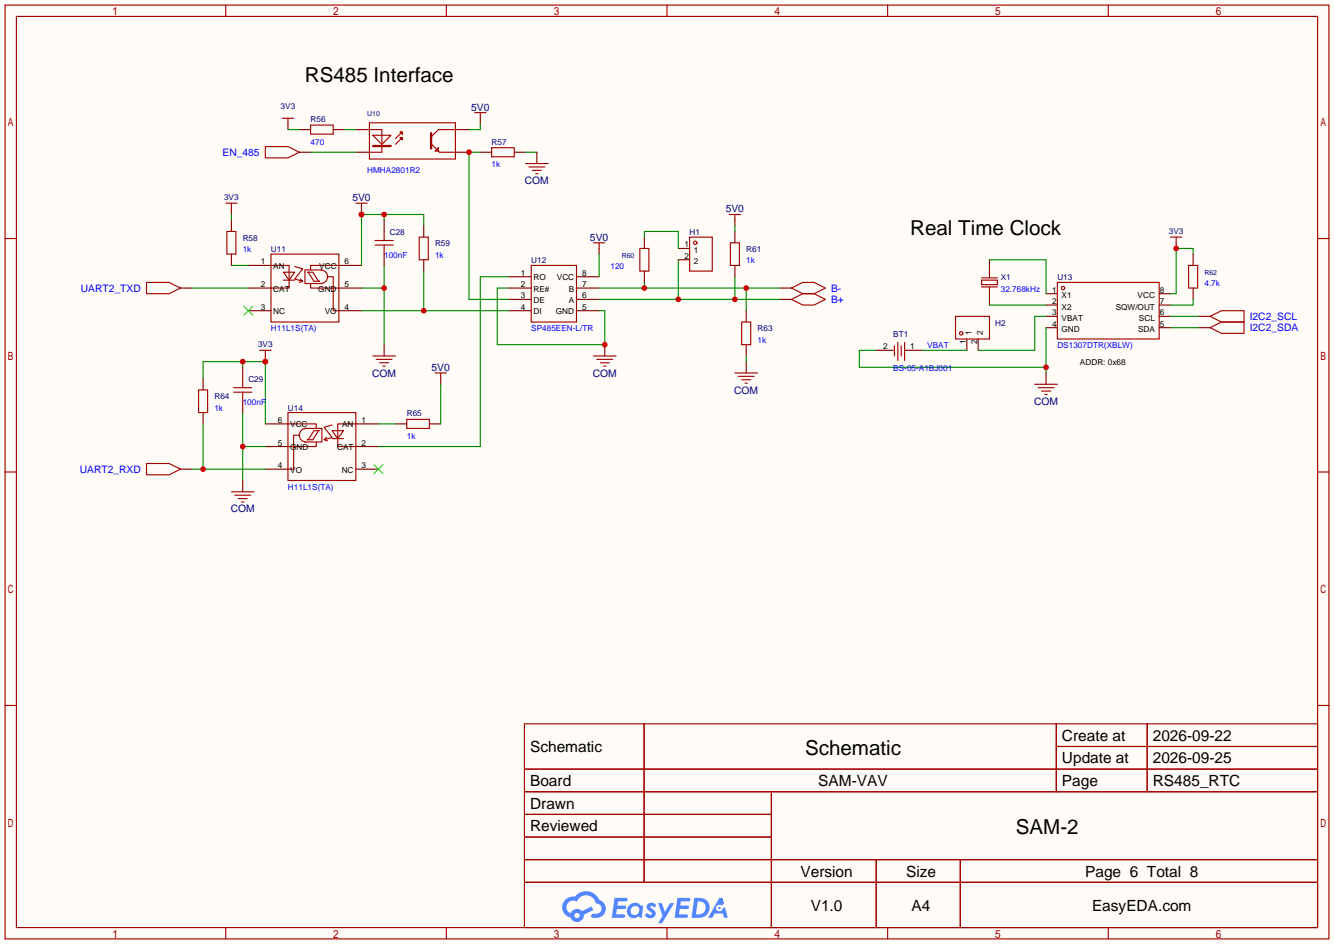
[picture p31: page 6]

Schematic | Schematic | Create at | 2026-09-22

Update at | 2026-09-25

Board | SAM-VAV | Page | RS485_RTC
Drawn | | SAM-2
Reviewed

RJ45 WALL SENSOR | 3V3

# SDP810 Sensor

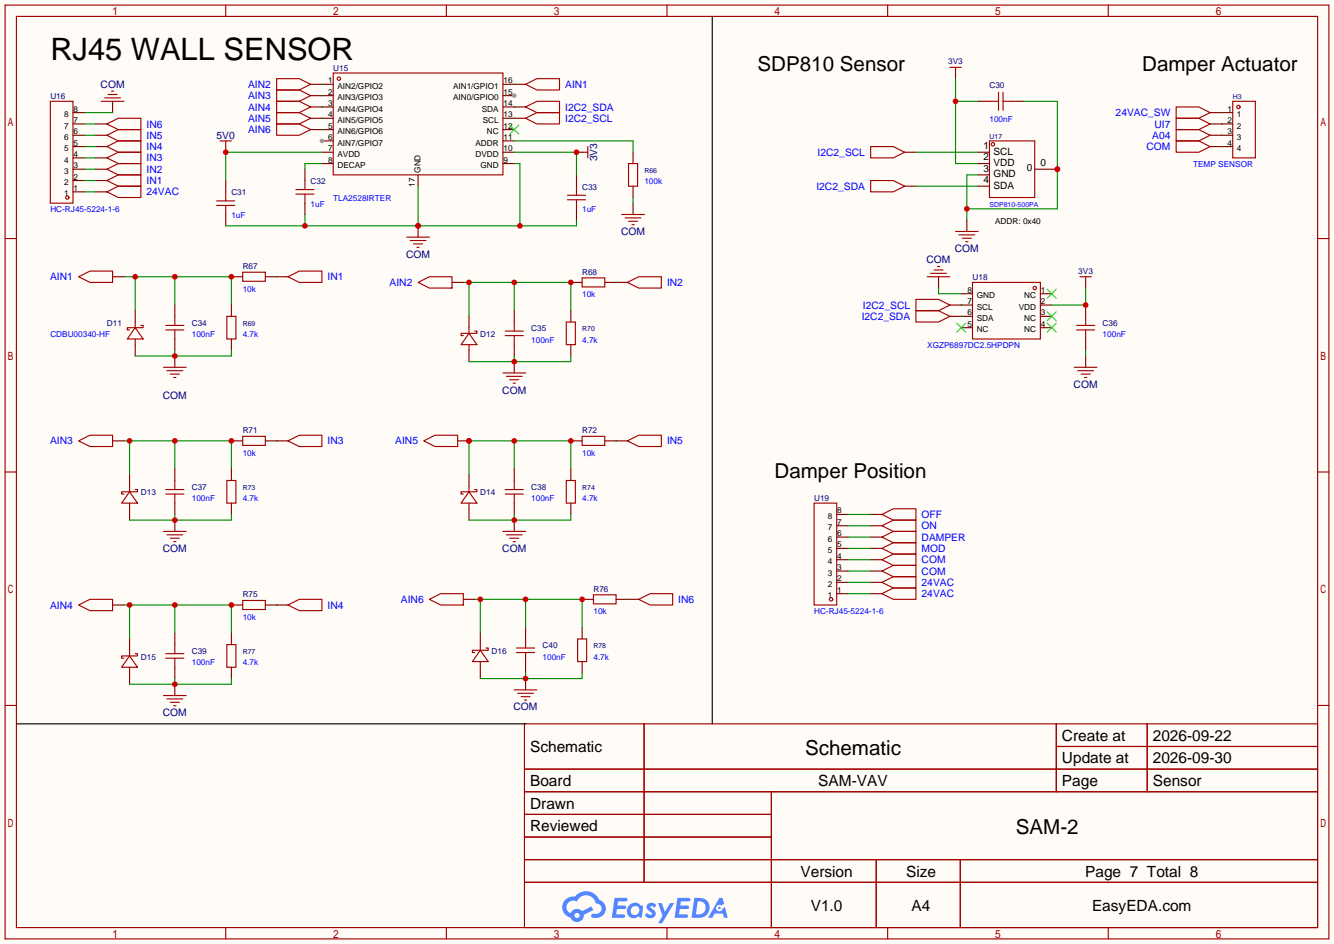
[picture p32: page 7]

DVDD 10 ADDR 11 NC 12 SCL 13 SDA 14 AIN0/GPIO0 15 AIN1/GPIO1 16

Update at | 2026-09-30

Board | SAM-VAV | Page | Sensor
Drawn | | SAM-2
Reviewed

# Watchdog Timer (WDT)

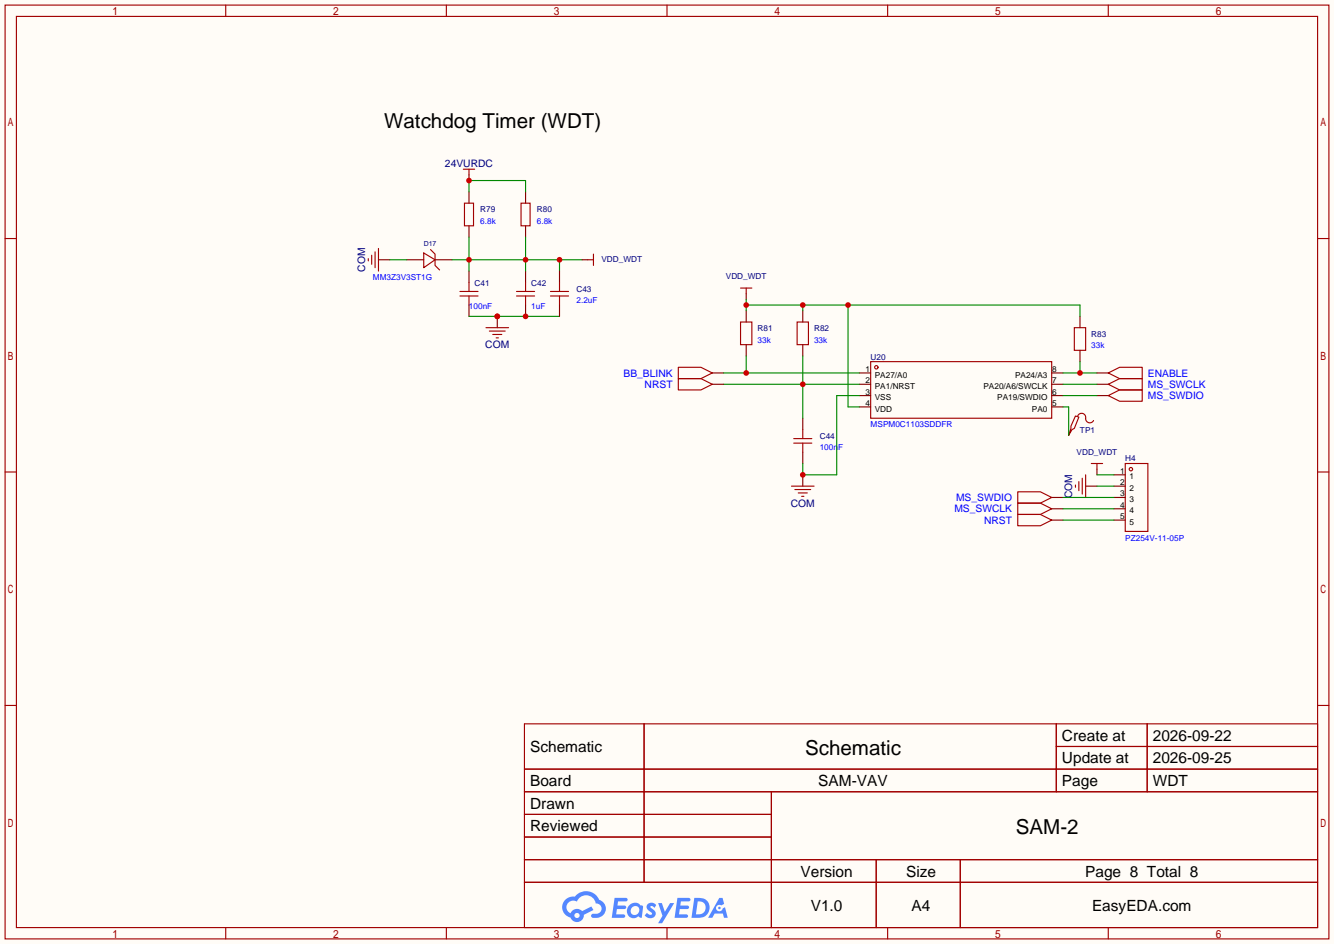
[picture p33: page 8]

Schematic | Schematic | Create at | 2026-09-22

Update at | 2026-09-25

Board | SAM-VAV | Page | WDT
Drawn | | SAM-2
Reviewed
