ZyntelliTech/Solidyne-SAM-BBG/schematic/SAM-VAV-SCH_09-24.pdf

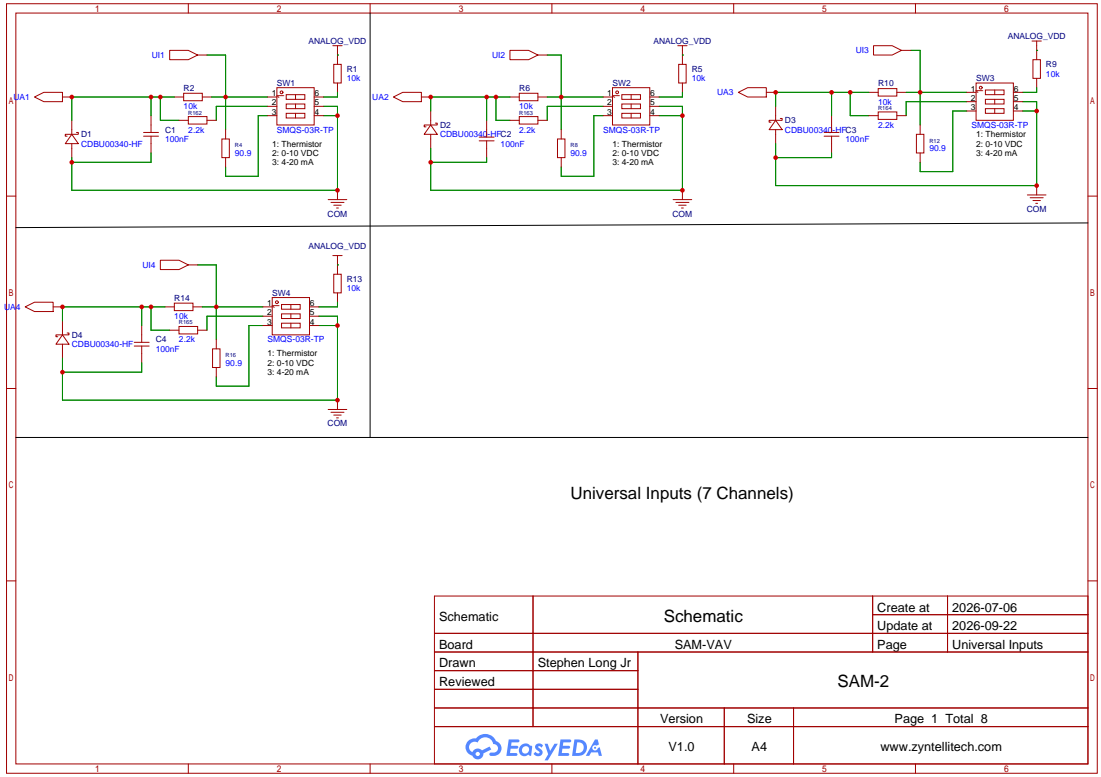
[picture p34: page 1]

Schematic | Schematic | Create at | 2026-07-06

Update at | 2026-09-22

Board | SAM-VAV | Page | Universal Inputs
Drawn | Stephen Long Jr | SAM-2
Reviewed

Version | Size | Page 1 Total 8
V1.0 | A4 | www.zyntellitech.com

Analog Output - 1 | Analog Output - 2

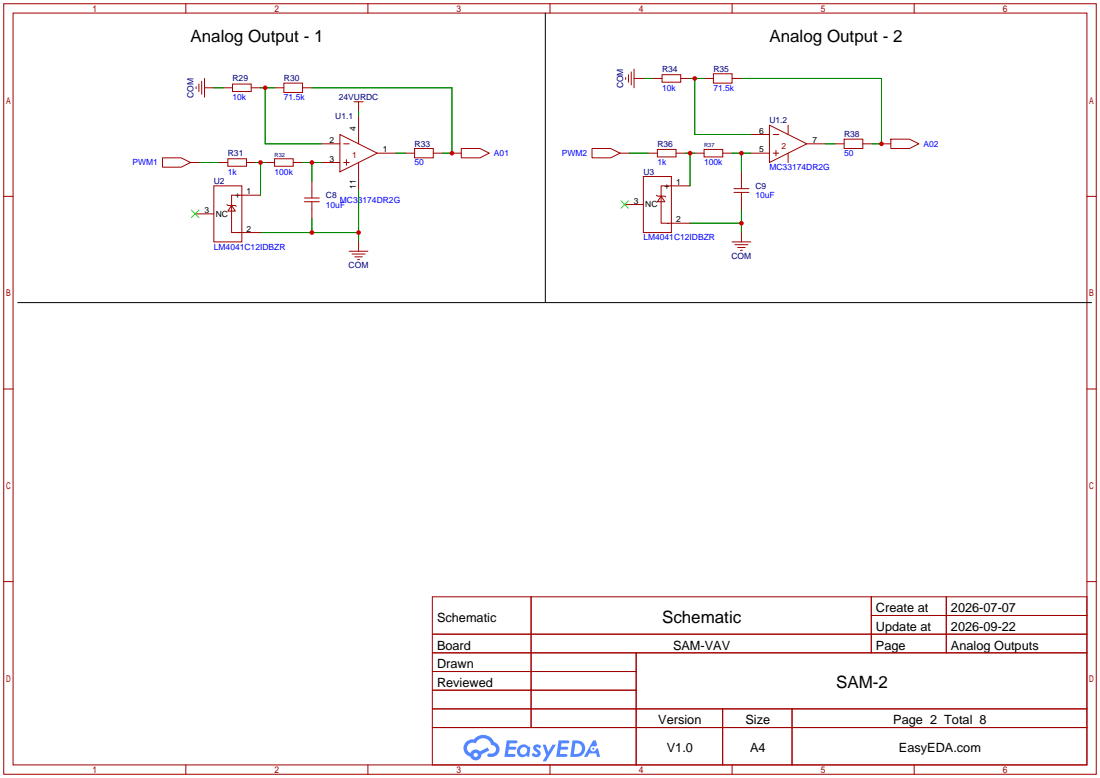
[picture p35: page 2]

Schematic | Schematic | Create at | 2026-07-07

Update at | 2026-09-22

Board | SAM-VAV | Page | Analog Outputs
Drawn | | SAM-2
Reviewed

Version | Size | Page 2 Total 8
V1.0 | A4 | EasyEDA.com

TRIAC - 1 | TRIAC - 2

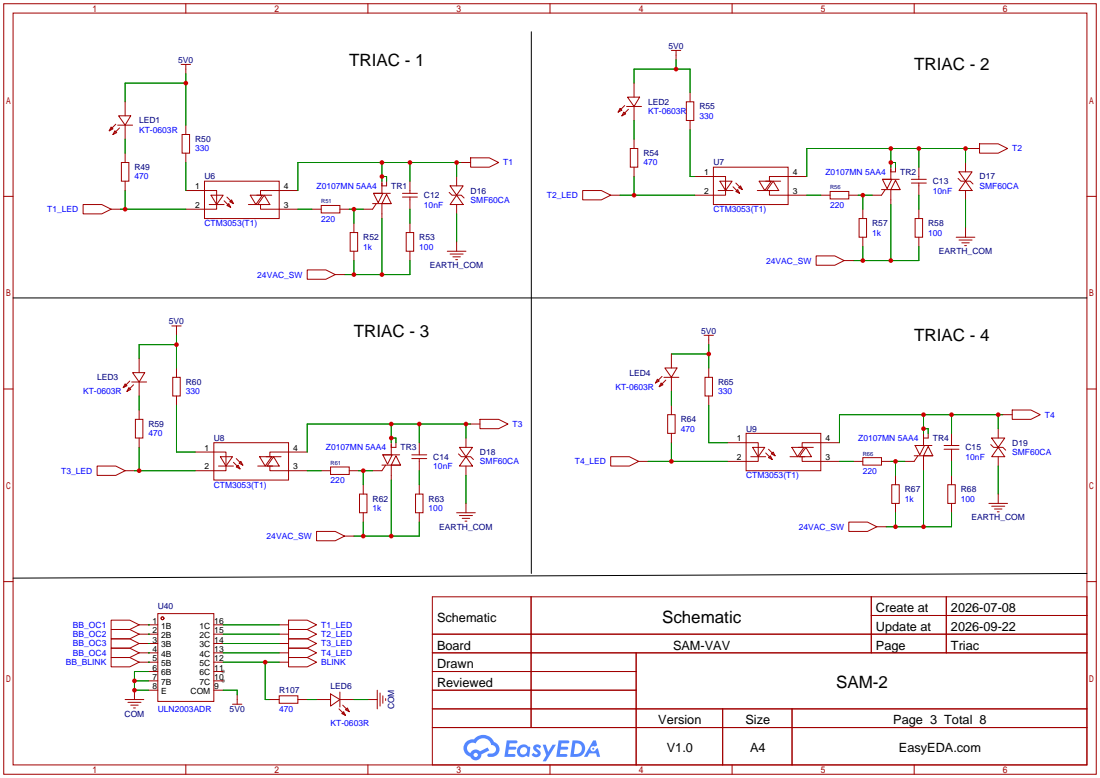
[picture p36: page 3]

Schematic | Schematic | Create at | 2026-07-08

Update at | 2026-09-22

Board | SAM-VAV | Page | Triac
Drawn | | SAM-2
Reviewed

# 24VAC to 5V Power Regulator

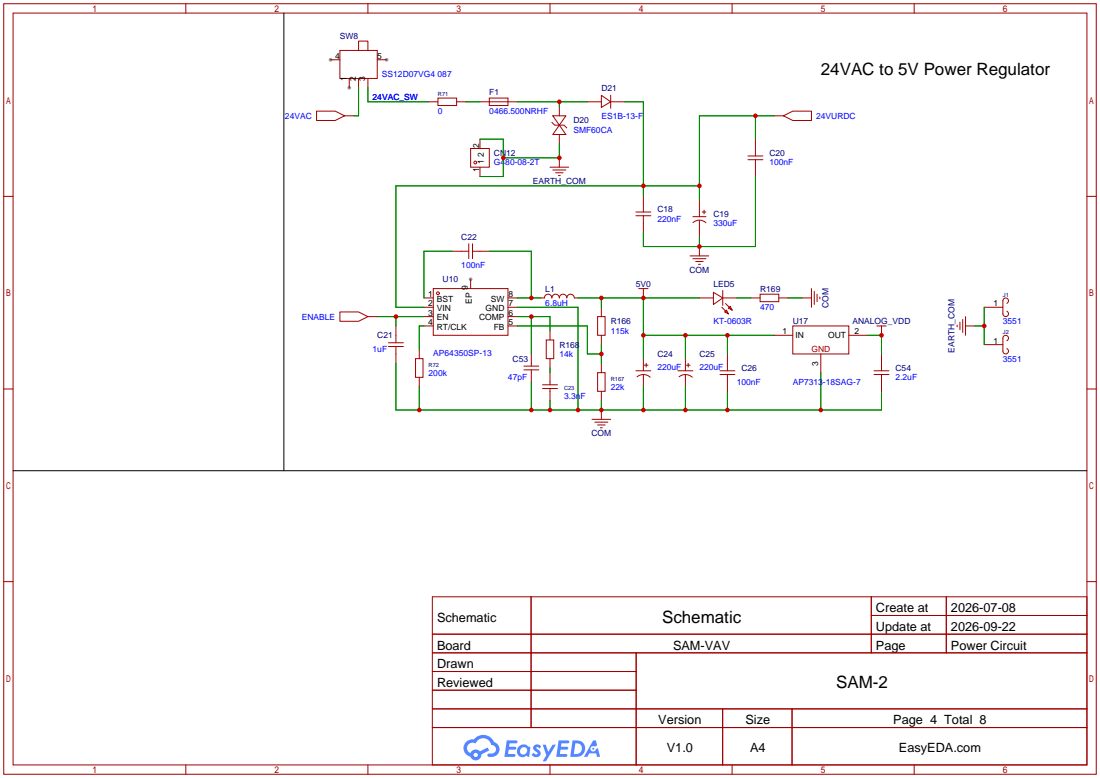
[picture p37: page 4]

Schematic | Schematic | Create at | 2026-07-08

Update at | 2026-09-22

Board | SAM-VAV | Page | Power Circuit
Drawn | | SAM-2
Reviewed

# BeagleBone Connector IO Connectors

CN11 1

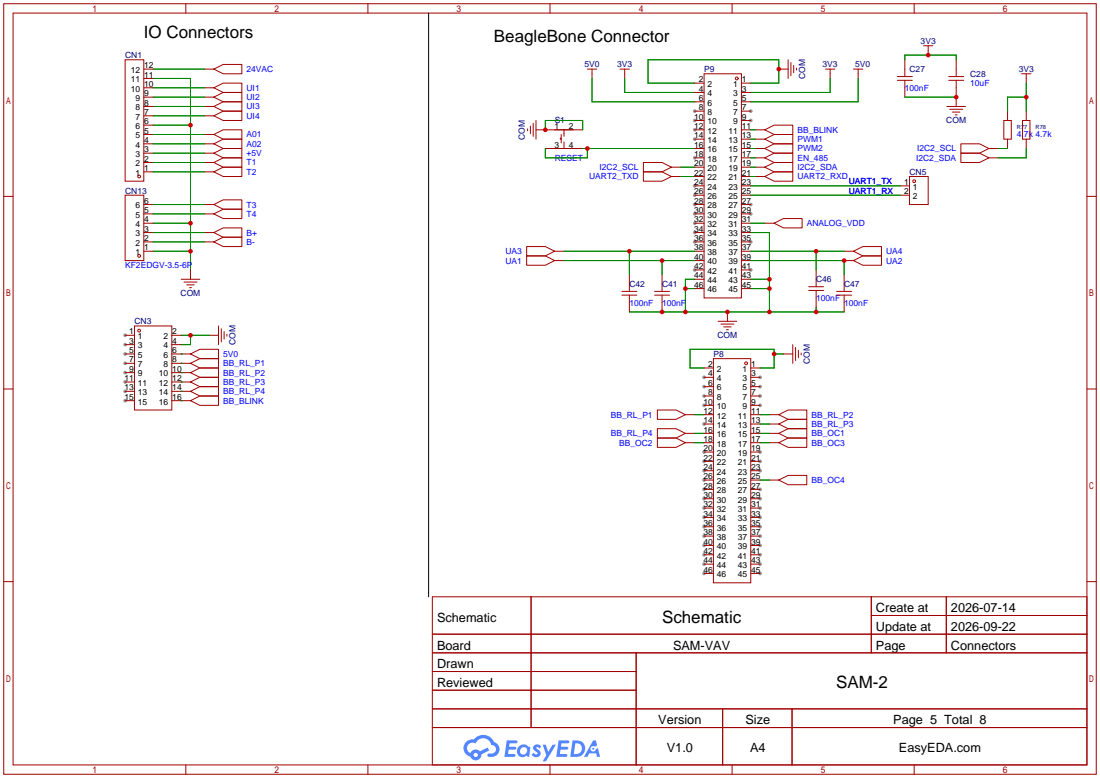
[picture p38: page 5]

Schematic | Schematic | Create at | 2026-07-14

Update at | 2026-09-22

Board | SAM-VAV | Page | Connectors
Drawn | | SAM-2
Reviewed

# RS485 Interface

# Real Time Clock

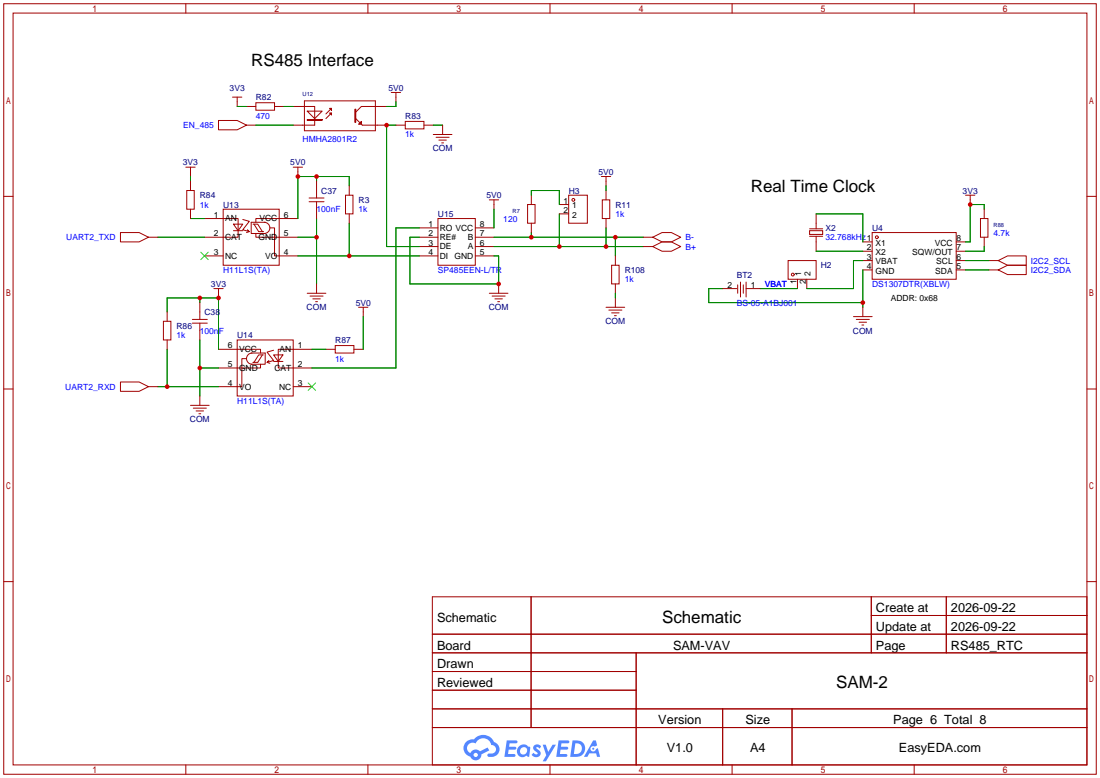
[picture p39: page 6]

Schematic | Schematic | Create at | 2026-09-22

Update at | 2026-09-22

Board | SAM-VAV | Page | RS485_RTC
Drawn | | SAM-2
Reviewed

# RJ45 WALL SENSOR

# SDP510 Sensor

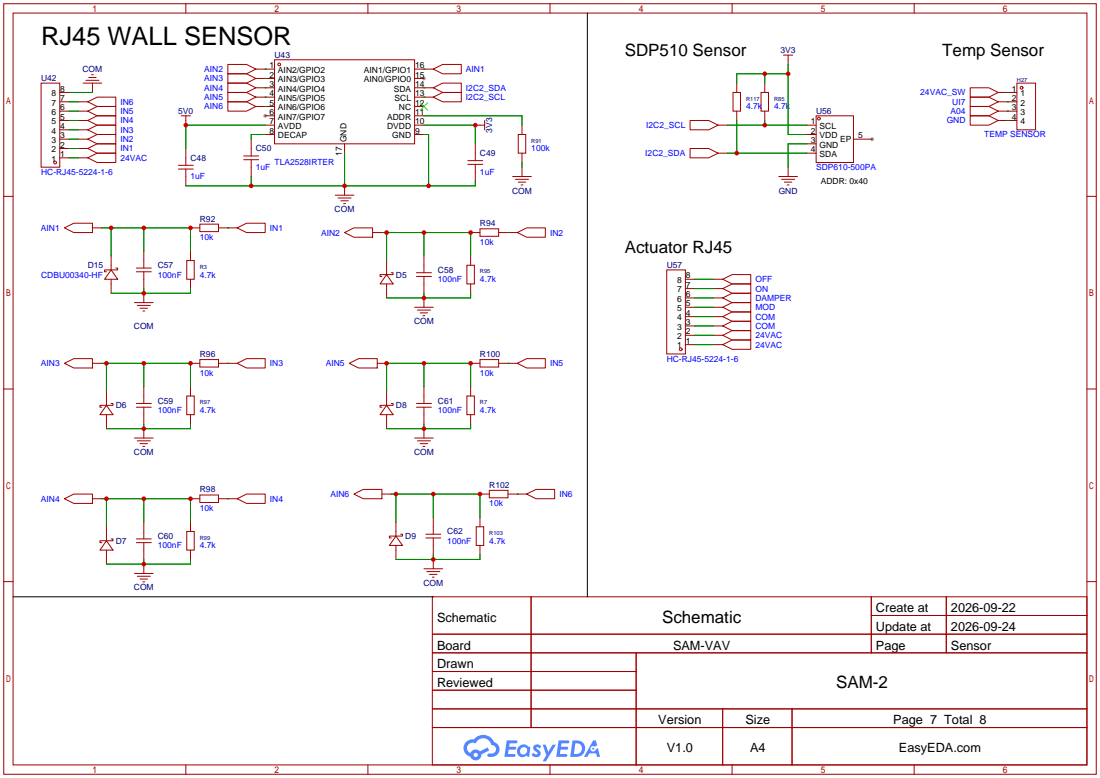
[picture p40: page 7]

DVDD 10 ADDR 11 NC 12 SCL 13 SDA 14 AIN0/GPIO0 15 AIN1/GPIO1 16

Update at | 2026-09-24

Board | SAM-VAV | Page | Sensor
Drawn | | SAM-2
Reviewed

# Watchdog Timer (WDT)

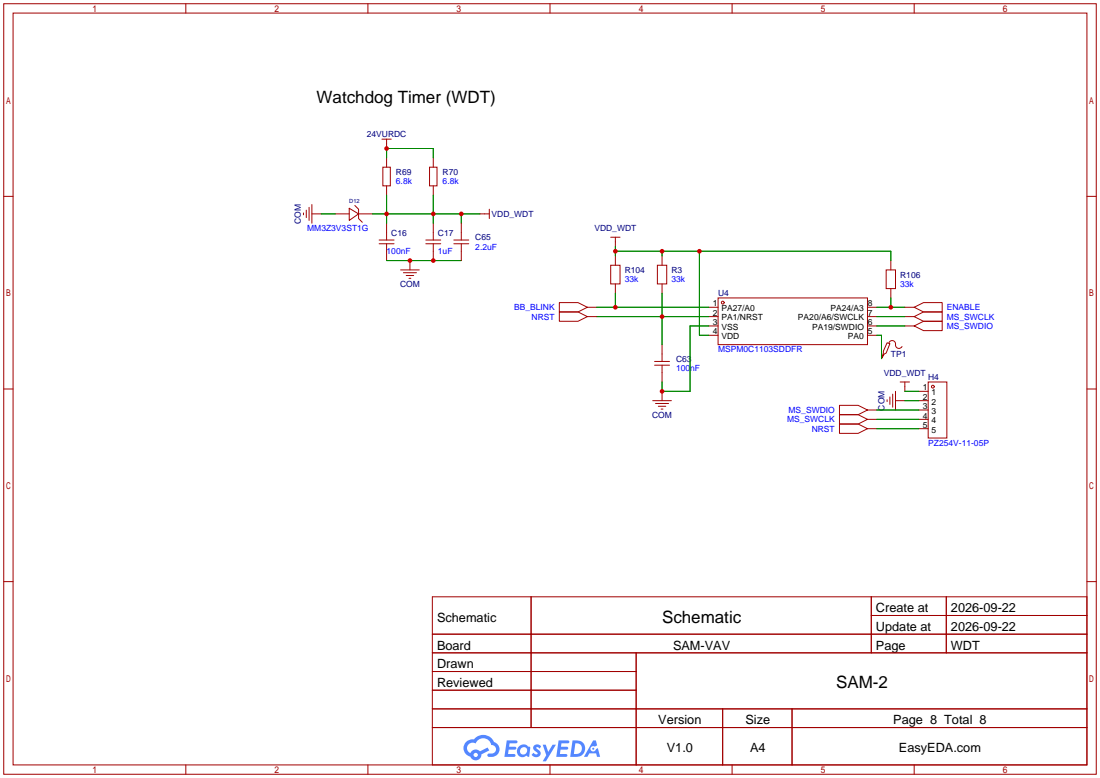
[picture p41: page 8]

Schematic | Schematic | Create at | 2026-09-22

Update at | 2026-09-22

Board | SAM-VAV | Page | WDT
Drawn | | SAM-2
Reviewed
