ZyntelliTech/Solidyne-SAM-BBG/schematic/SCH_Schematic1_2026-09-21.pdf

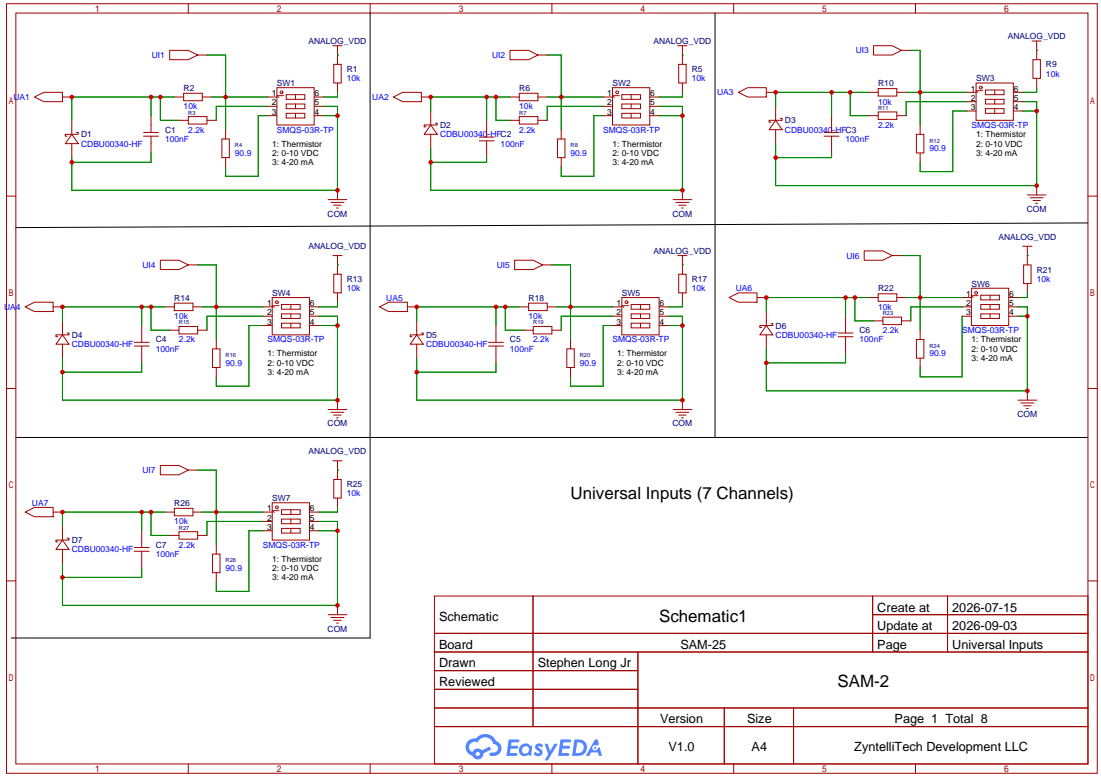
[picture p47: page 1]

Schematic | Schematic1 | Create at | 2026-07-15

Update at | 2026-09-03

Board | SAM-25 | Page | Universal Inputs
Drawn | Stephen Long Jr | SAM-2
Reviewed

Version | Size | Page 1 Total 8
V1.0 | A4 | ZyntelliTech Development LLC

Analog Output - 1 | Analog Output - 2

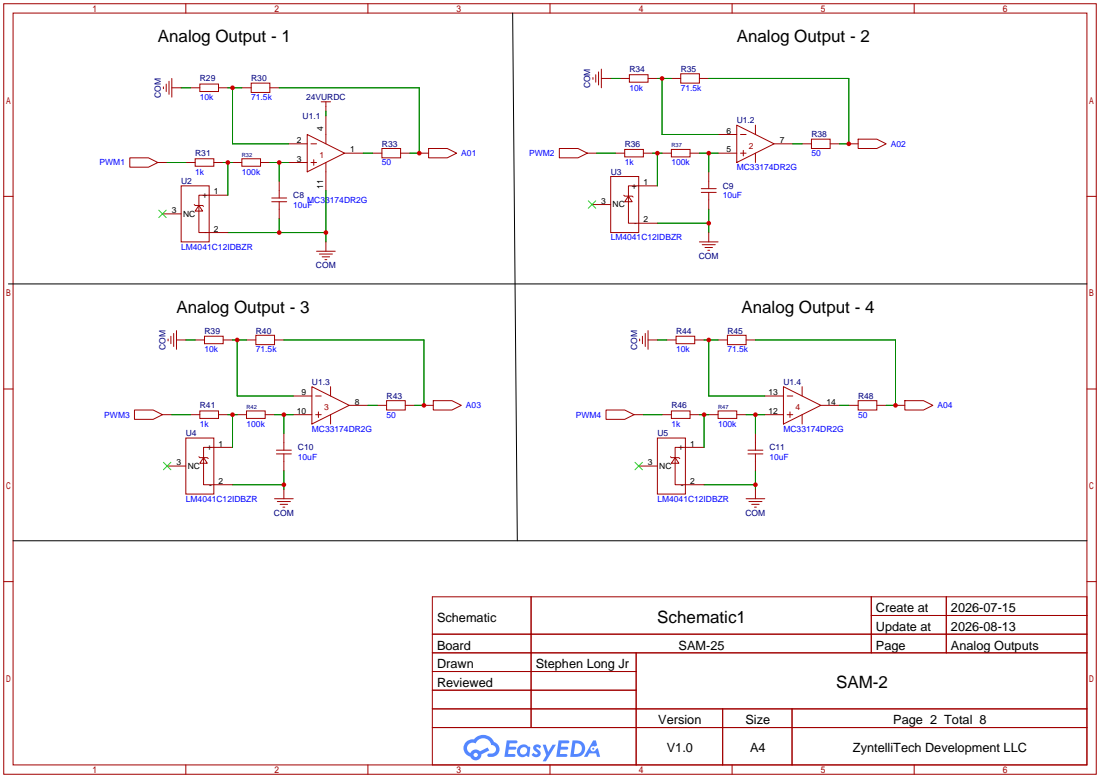
[picture p48: page 2]

Schematic | Schematic1 | Create at | 2026-07-15

Update at | 2026-08-13

Board | SAM-25 | Page | Analog Outputs
Drawn | Stephen Long Jr | SAM-2
Reviewed

TRIAC - 1 | TRIAC - 2

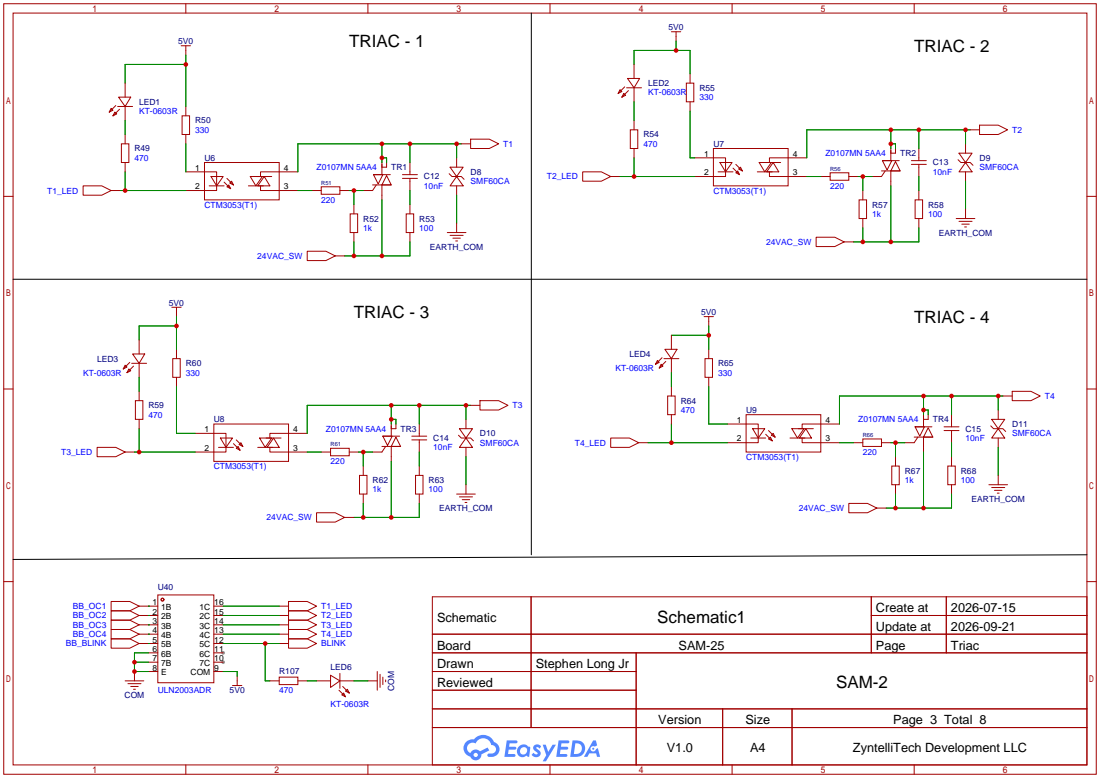
[picture p49: page 3]

Schematic | Schematic1 | Create at | 2026-07-15

Update at | 2026-09-21

Board | SAM-25 | Page | Triac
Drawn | Stephen Long Jr | SAM-2
Reviewed

# 24VAC to 5V Power Regulator

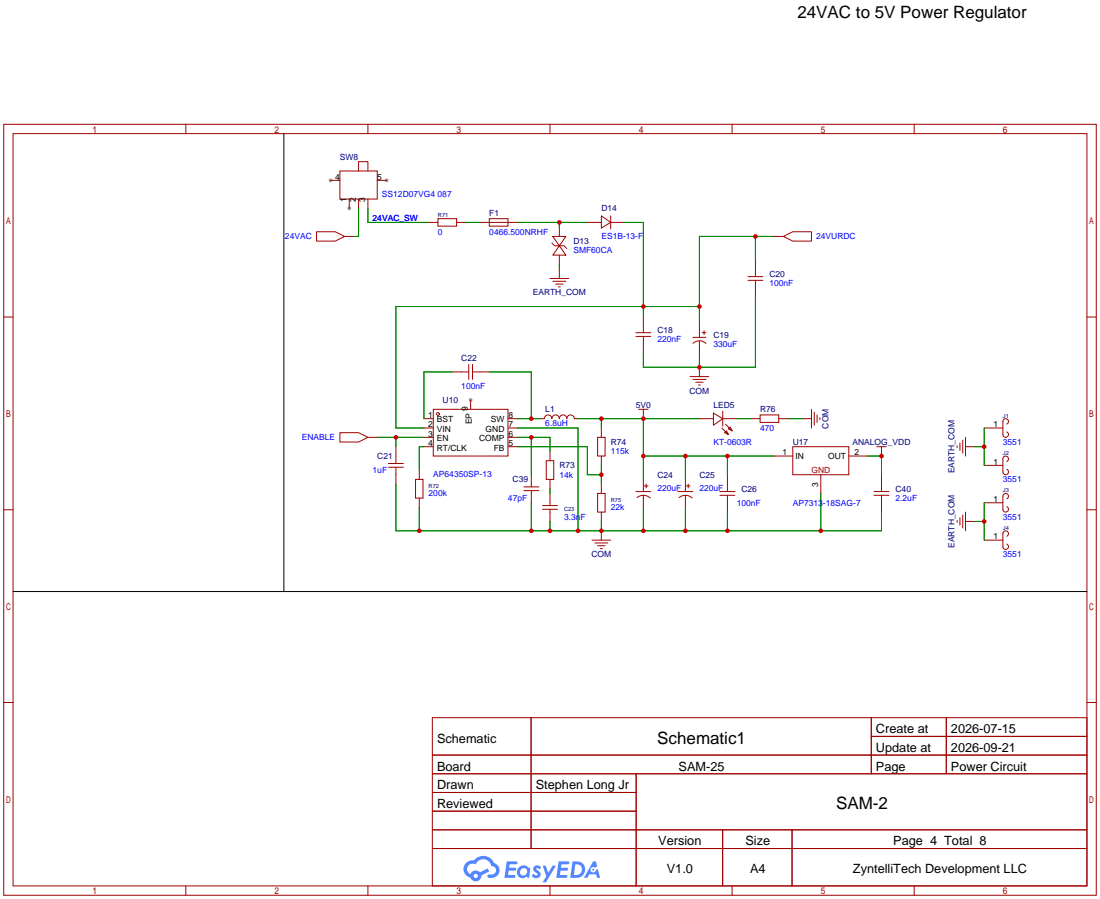
[picture p50: page 4]

Schematic | Schematic1 | Create at | 2026-07-15

Update at | 2026-09-21

Board | SAM-25 | Page | Power Circuit
Drawn | Stephen Long Jr | SAM-2
Reviewed

# BeagleBone Connector IO Connectors

CN11

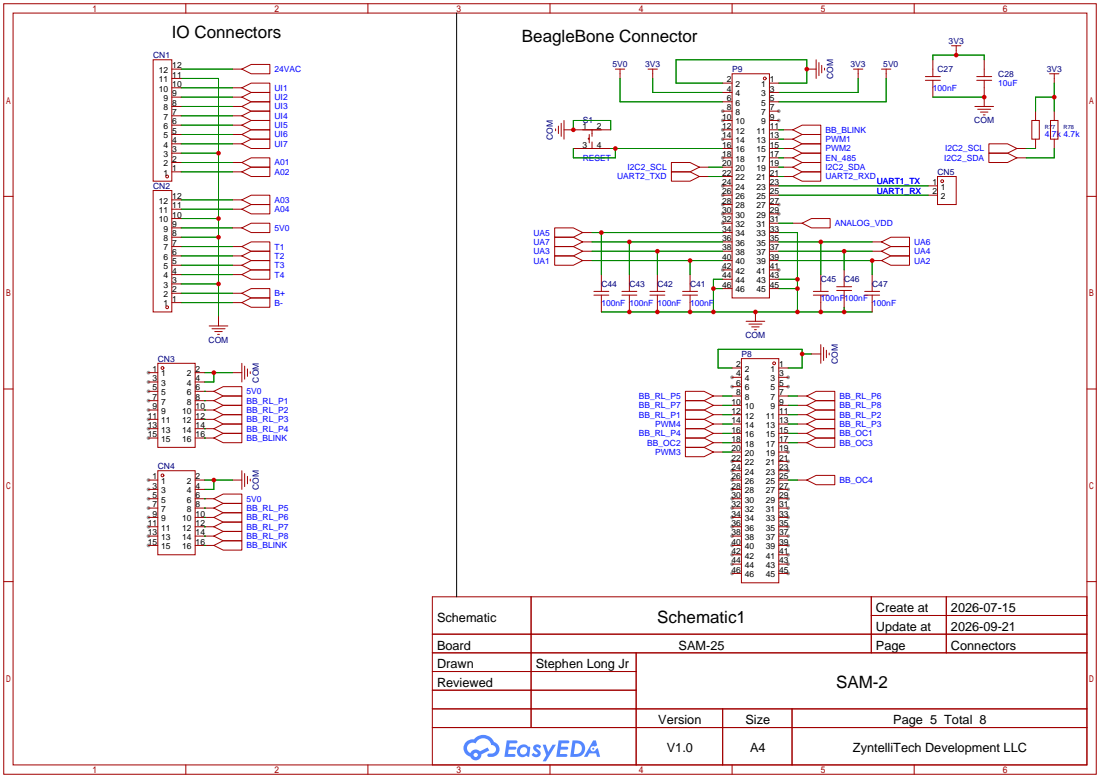
[picture p51: page 5]

Schematic | Schematic1 | Create at | 2026-07-15

Update at | 2026-09-21

Board | SAM-25 | Page | Connectors
Drawn | Stephen Long Jr | SAM-2
Reviewed

# RS485 Interface

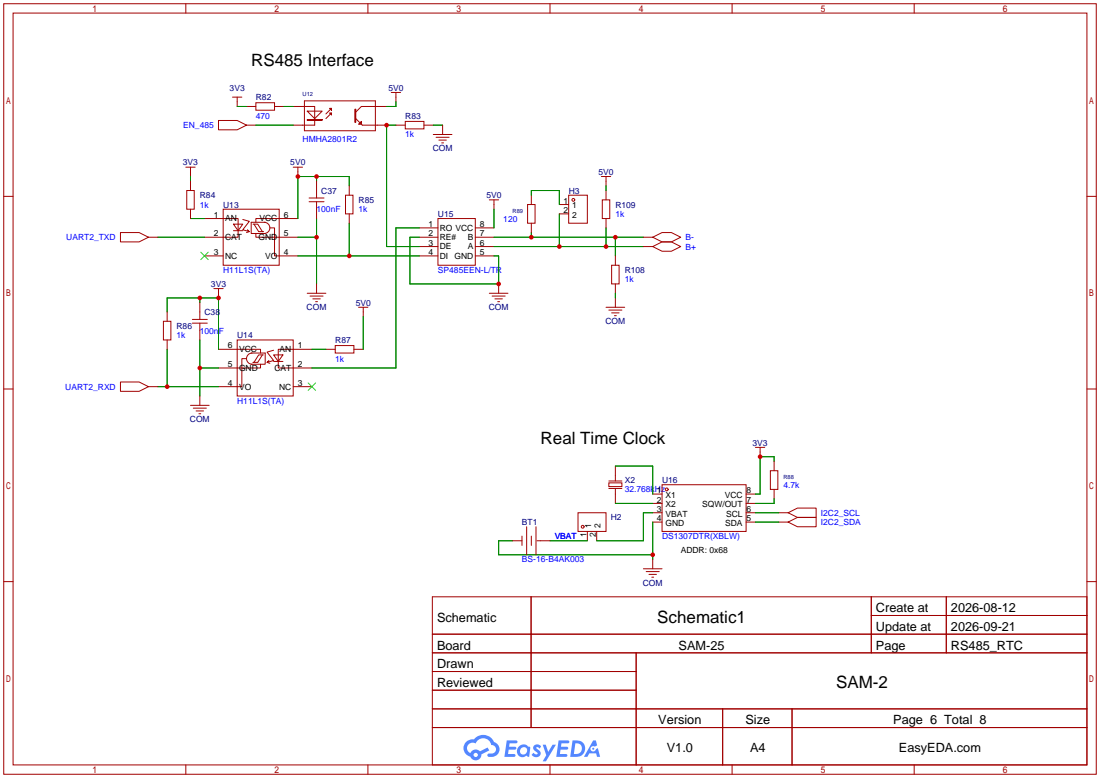
[picture p52: page 6]

Schematic | Schematic1 | Create at | 2026-08-12

Update at | 2026-09-21

Board | SAM-25 | Page | RS485_RTC
Drawn | | SAM-2
Reviewed

Version | Size | Page 6 Total 8
V1.0 | A4 | EasyEDA.com

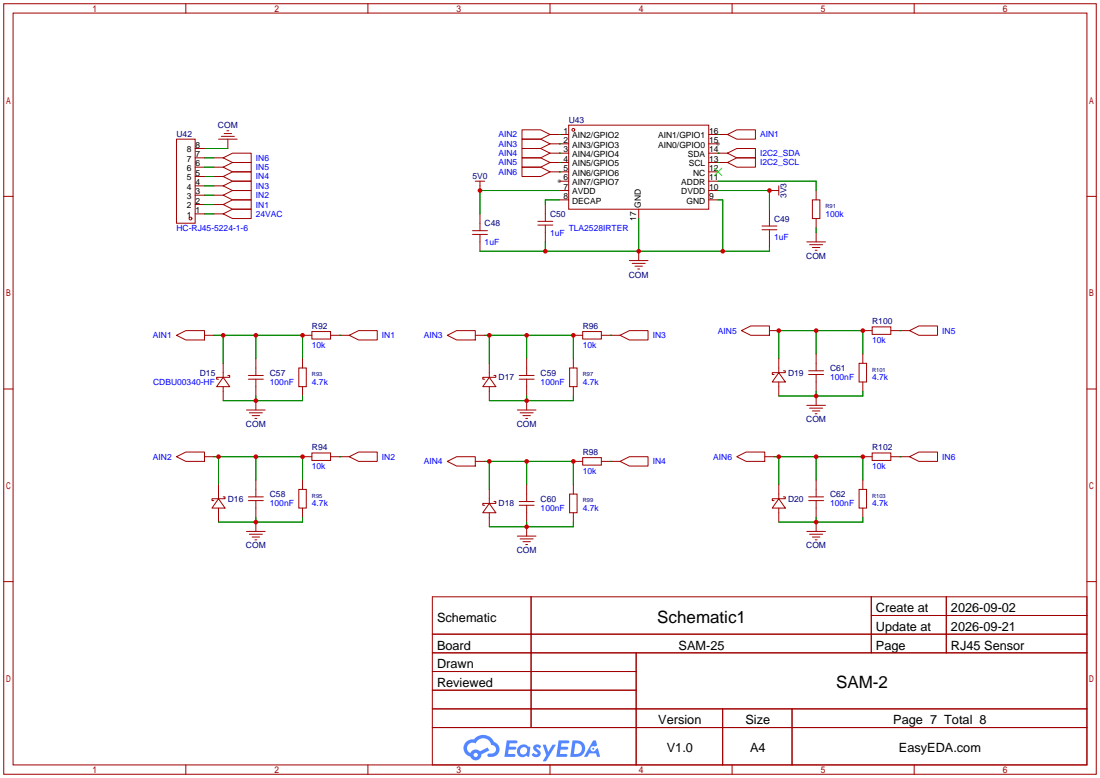
[picture p53: page 7]

DVDD 10 ADDR 11 NC 12 SCL 13 SDA 14 AIN0/GPIO0 15 AIN1/GPIO1 16

Schematic | Schematic1 | Create at | 2026-09-02

Update at | 2026-09-21

Board | SAM-25 | Page | RJ45 Sensor
Drawn | | SAM-2
Reviewed

Version | Size | Page 7 Total 8
V1.0 | A4 | EasyEDA.com

# Watchdog Timer (WDT)

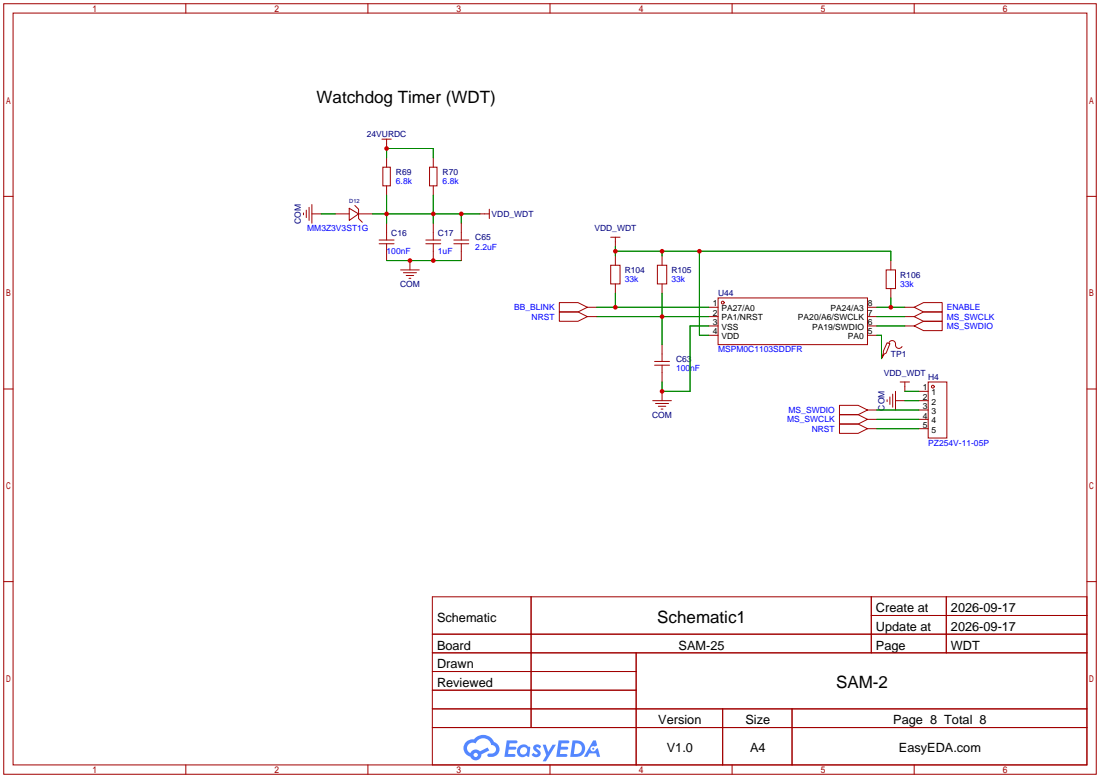
[picture p54: page 8]

Schematic | Schematic1 | Create at | 2026-09-17

Update at | 2026-09-17

Board | SAM-25 | Page | WDT
Drawn | | SAM-2
Reviewed

Version | Size | Page 8 Total 8
V1.0 | A4 | EasyEDA.com
