ZyntelliTech/Solidyne-SAM-BBG/schematic/SCH_SAM25_2026-08-26.pdf

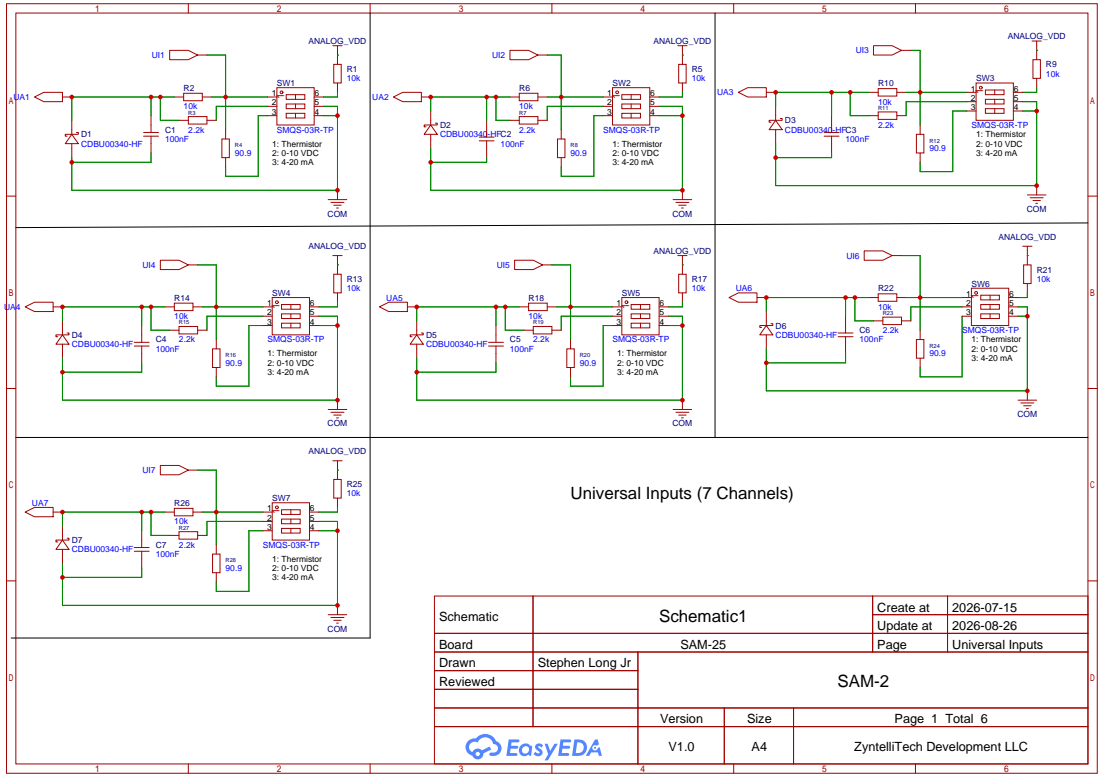
[picture p63: page 1]

Schematic | Schematic1 | Create at | 2026-07-15

Update at | 2026-08-26

Board | SAM-25 | Page | Universal Inputs
Drawn | Stephen Long Jr | SAM-2
Reviewed

Version | Size | Page 1 Total 6
V1.0 | A4 | ZyntelliTech Development LLC

Analog Output - 1 | Analog Output - 2

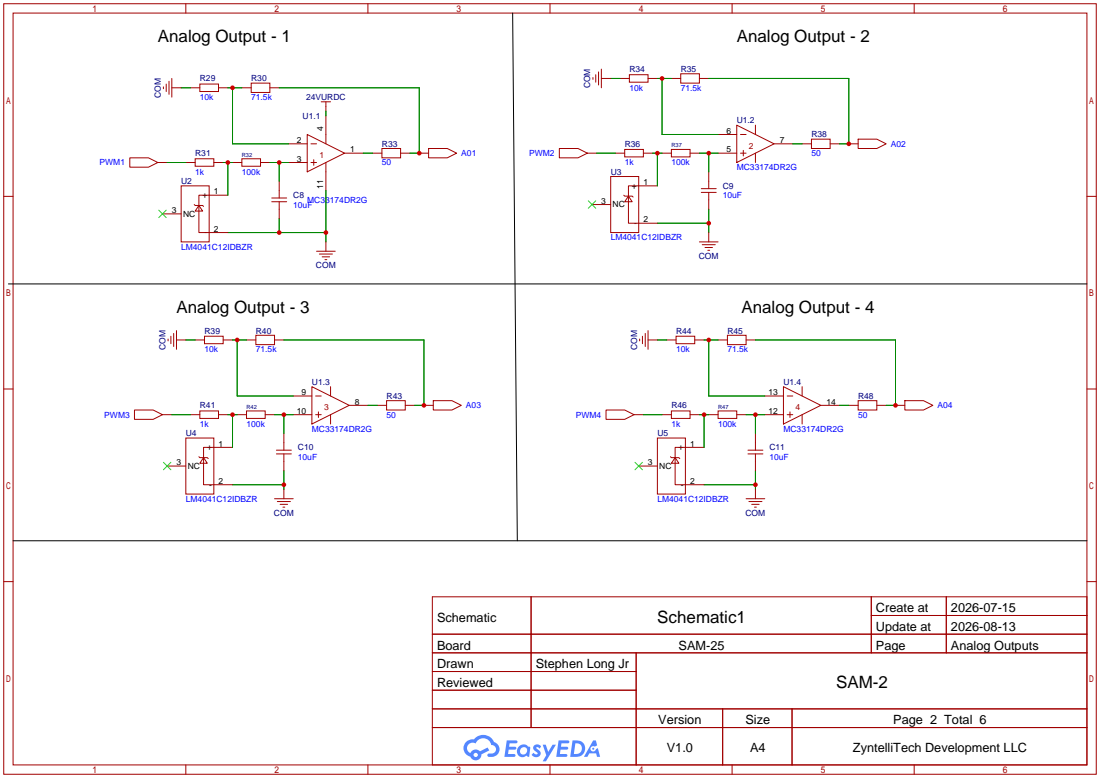
[picture p64: page 2]

Schematic | Schematic1 | Create at | 2026-07-15

Update at | 2026-08-13

Board | SAM-25 | Page | Analog Outputs
Drawn | Stephen Long Jr | SAM-2
Reviewed

TRIAC - 1 | TRIAC - 2

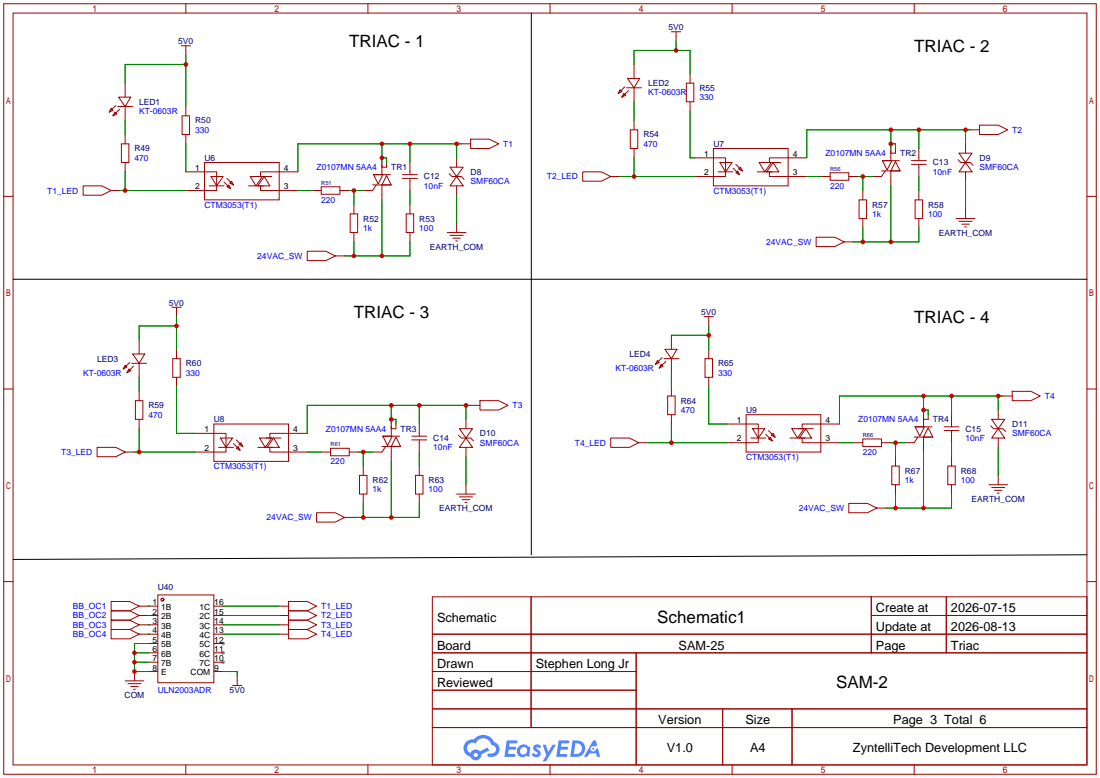
[picture p65: page 3]

Schematic | Schematic1 | Create at | 2026-07-15

Update at | 2026-08-13

Board | SAM-25 | Page | Triac
Drawn | Stephen Long Jr | SAM-2
Reviewed

# Watchdog Timer (WDT)

# 24VAC to 5V Power Regulator

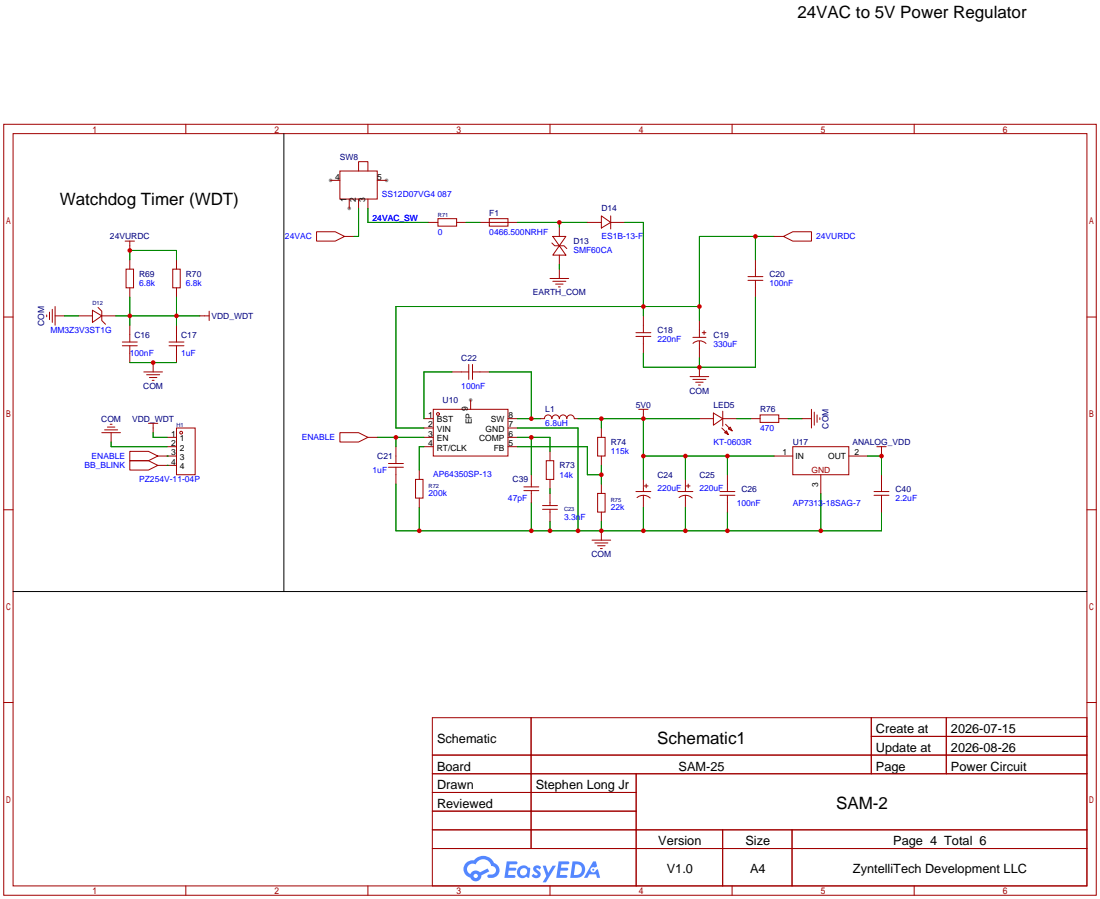
[picture p66: page 4]

Schematic | Schematic1 | Create at | 2026-07-15

Update at | 2026-08-26

Board | SAM-25 | Page | Power Circuit
Drawn | Stephen Long Jr | SAM-2
Reviewed

# BeagleBone Connector IO Connectors

CN11

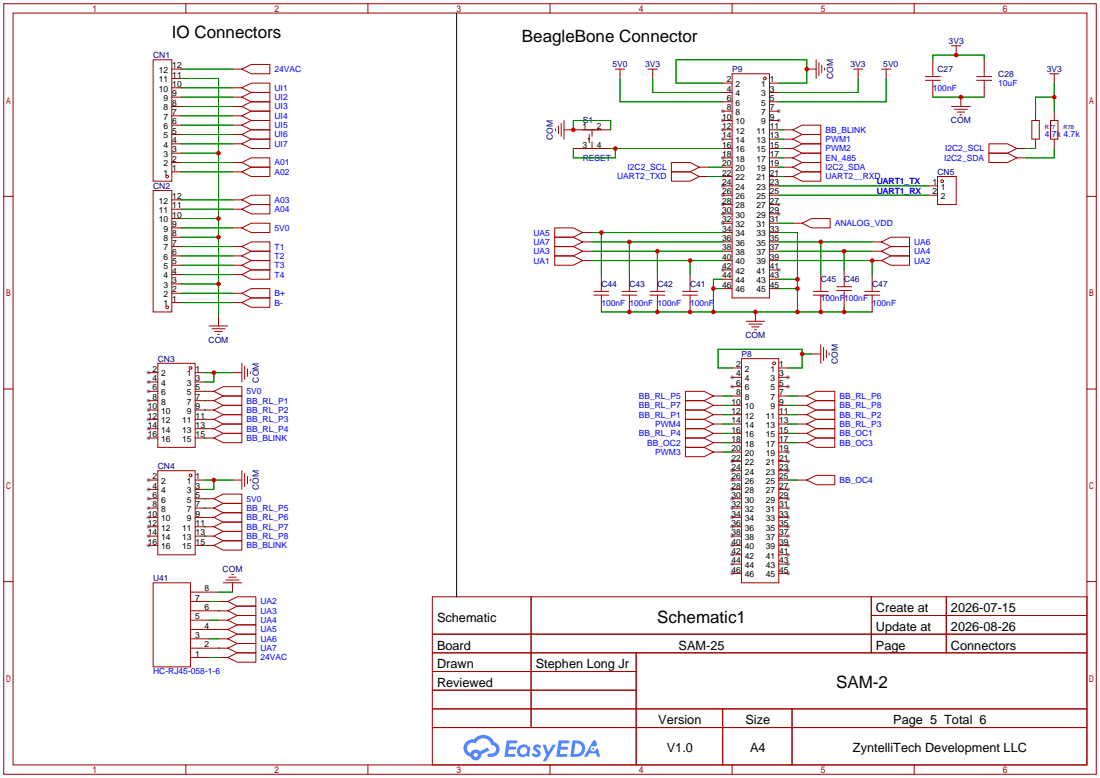
[picture p67: page 5]

Schematic | Schematic1 | Create at | 2026-07-15

Update at | 2026-08-26

Board | SAM-25 | Page | Connectors
Drawn | Stephen Long Jr | SAM-2
Reviewed

# RS485 Interface

COM | Real Time Clock

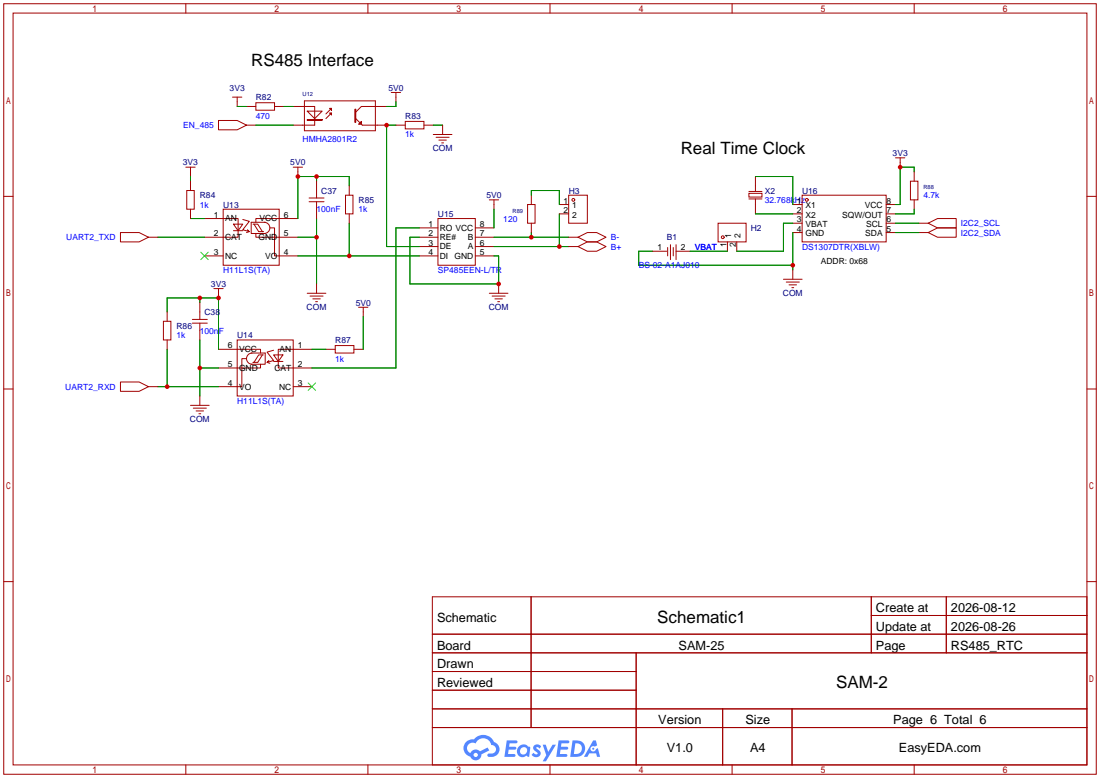
[picture p68: page 6]

Schematic | Schematic1 | Create at | 2026-08-12

Update at | 2026-08-26

Board | SAM-25 | Page | RS485_RTC
Drawn | | SAM-2
Reviewed

Version | Size | Page 6 Total 6
V1.0 | A4 | EasyEDA.com
