ZyntelliTech/Solidyne-SAM-BBG/SCH_SAM25.pdf

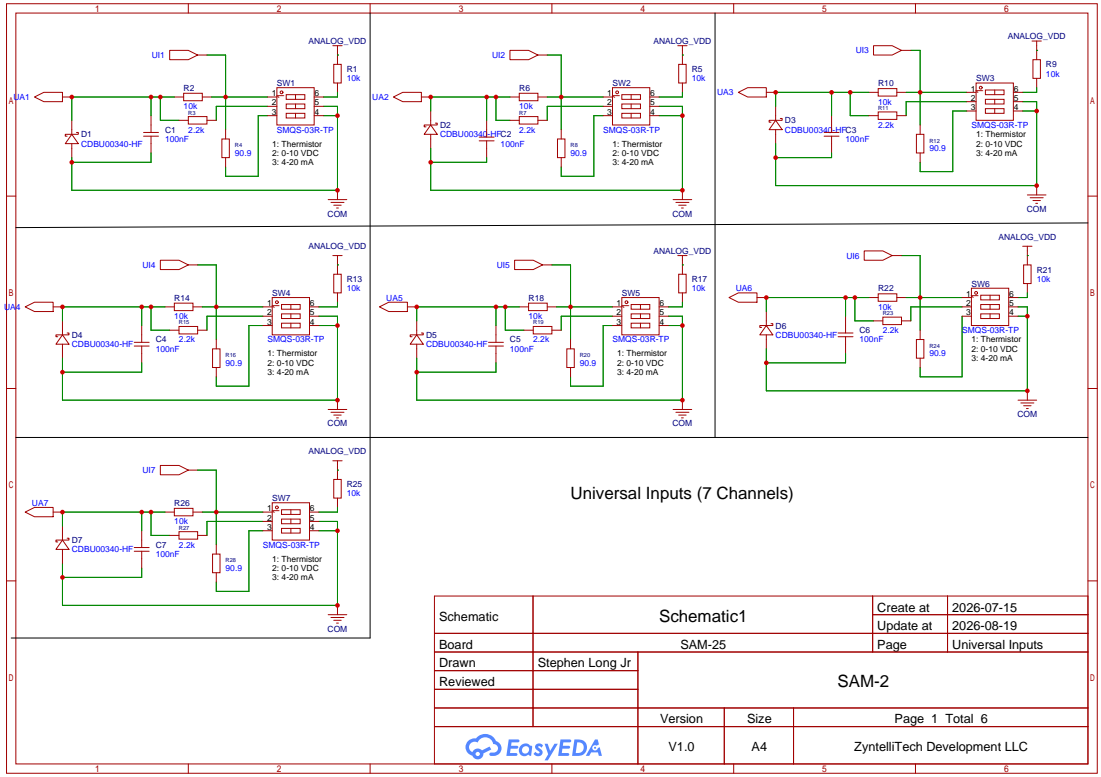
[picture p83: page 1]

Schematic | Schematic1 | Create at | 2026-07-15

Update at | 2026-08-19

Board | SAM-25 | Page | Universal Inputs
Drawn | Stephen Long Jr | SAM-2
Reviewed

Version | Size | Page 1 Total 6
V1.0 | A4 | ZyntelliTech Development LLC

Analog Output - 1 | Analog Output - 2


Schematic | Schematic1 | Create at | 2026-07-15

Update at | 2026-08-13

Board | SAM-25 | Page | Analog Outputs
Drawn | Stephen Long Jr | SAM-2
Reviewed

TRIAC - 1 | TRIAC - 2


Schematic | Schematic1 | Create at | 2026-07-15

Update at | 2026-08-13

Board | SAM-25 | Page | Triac
Drawn | Stephen Long Jr | SAM-2
Reviewed

# Watchdog Timer (WDT)

# 24VAC to 5V Power Regulator

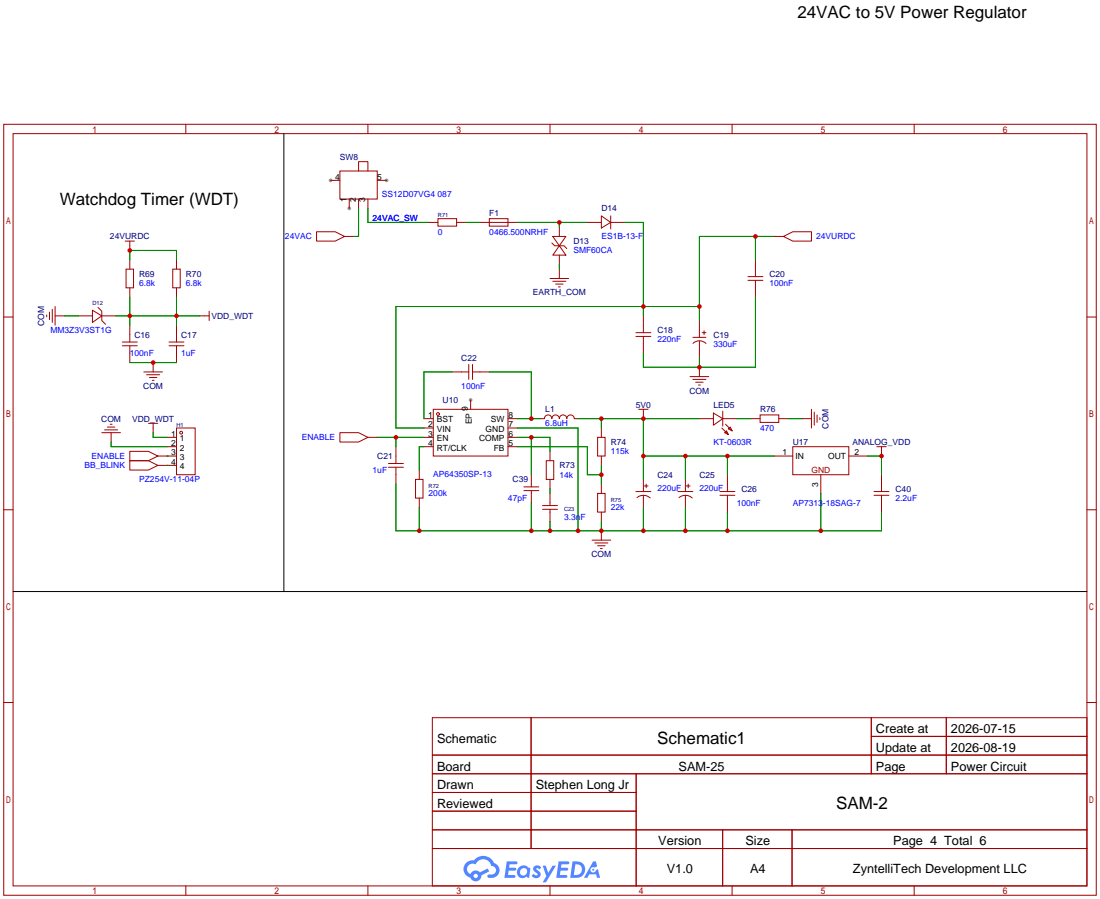
[picture p84: page 4]

Schematic | Schematic1 | Create at | 2026-07-15

Update at | 2026-08-19

Board | SAM-25 | Page | Power Circuit
Drawn | Stephen Long Jr | SAM-2
Reviewed

# BeagleBone Connector IO Connectors

CN11

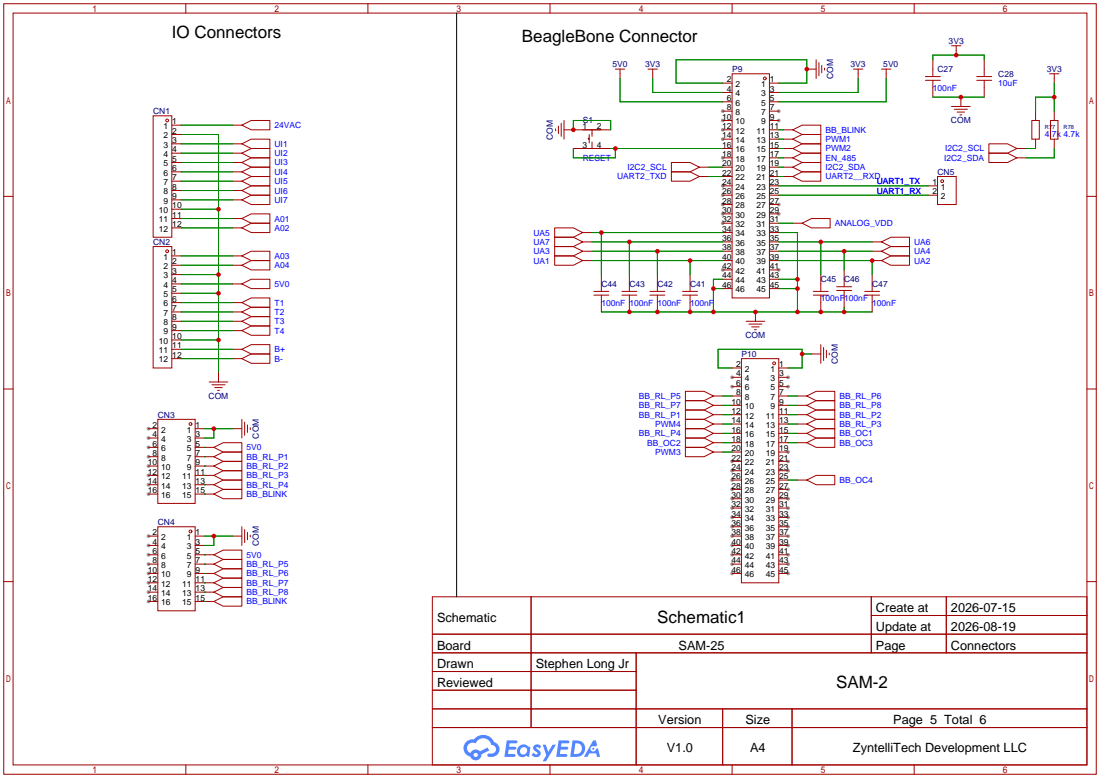
[picture p85: page 5]

Schematic | Schematic1 | Create at | 2026-07-15

Update at | 2026-08-19

Board | SAM-25 | Page | Connectors
Drawn | Stephen Long Jr | SAM-2
Reviewed

# RS485 Interface

COM | Real Time Clock

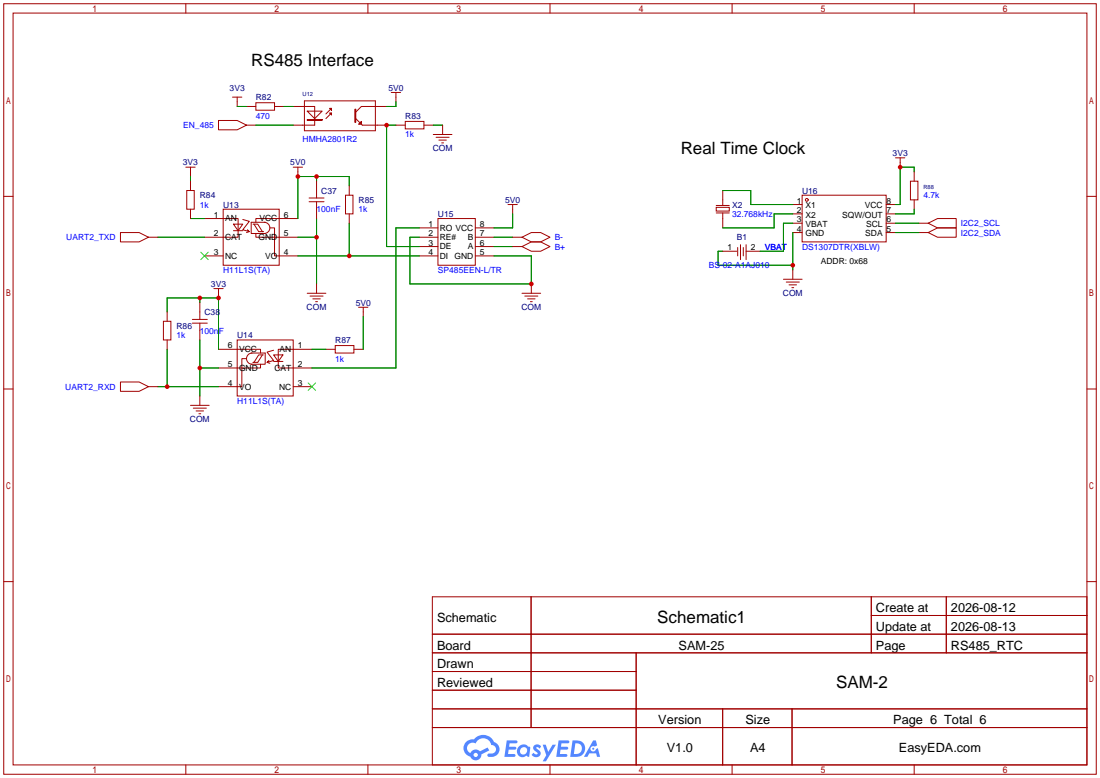
[picture p86: page 6]

Schematic | Schematic1 | Create at | 2026-08-12

Update at | 2026-08-13

Board | SAM-25 | Page | RS485_RTC
Drawn | | SAM-2
Reviewed

Version | Size | Page 6 Total 6
V1.0 | A4 | EasyEDA.com
