ZyntelliTech/Solidyne-SAM-BBG/WDT_SAM_Kicad/WDT_SAM.pdf

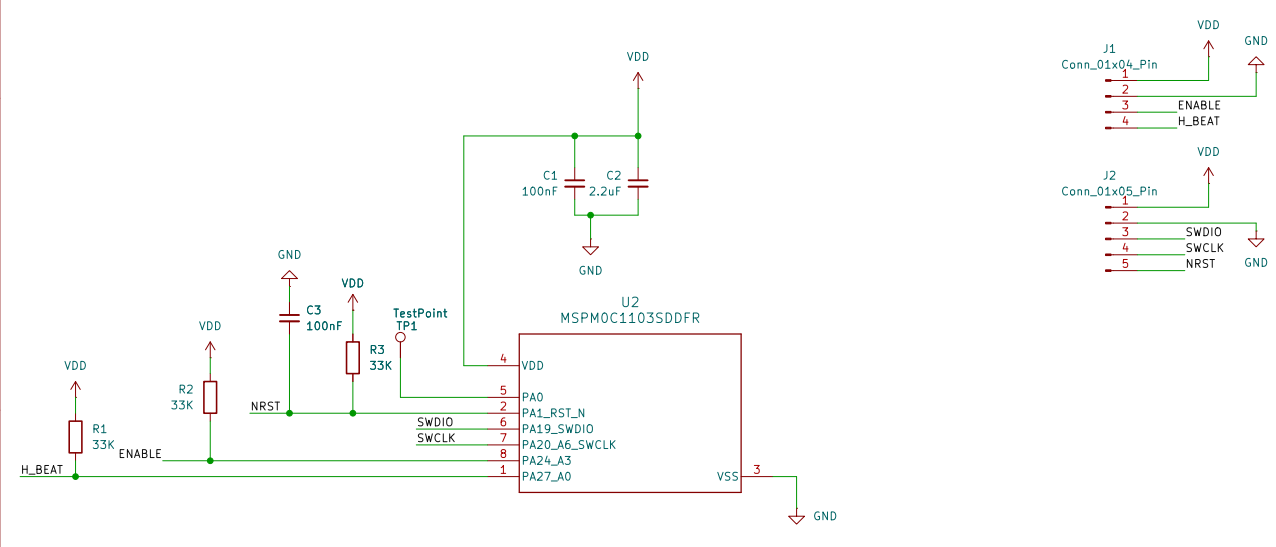
[picture p87: page 1]

Size: A4 | Rev:
KiCad E.D.A. 10.0.5 | Id: 1/1
