ZyntelliTech/Solidyne-SAM-BBG/layouts/SAM-VAV 81226.pdf

NO | DESCRIPTION | PART NUMBER | QTY

## 1 SAM-VAV 81226

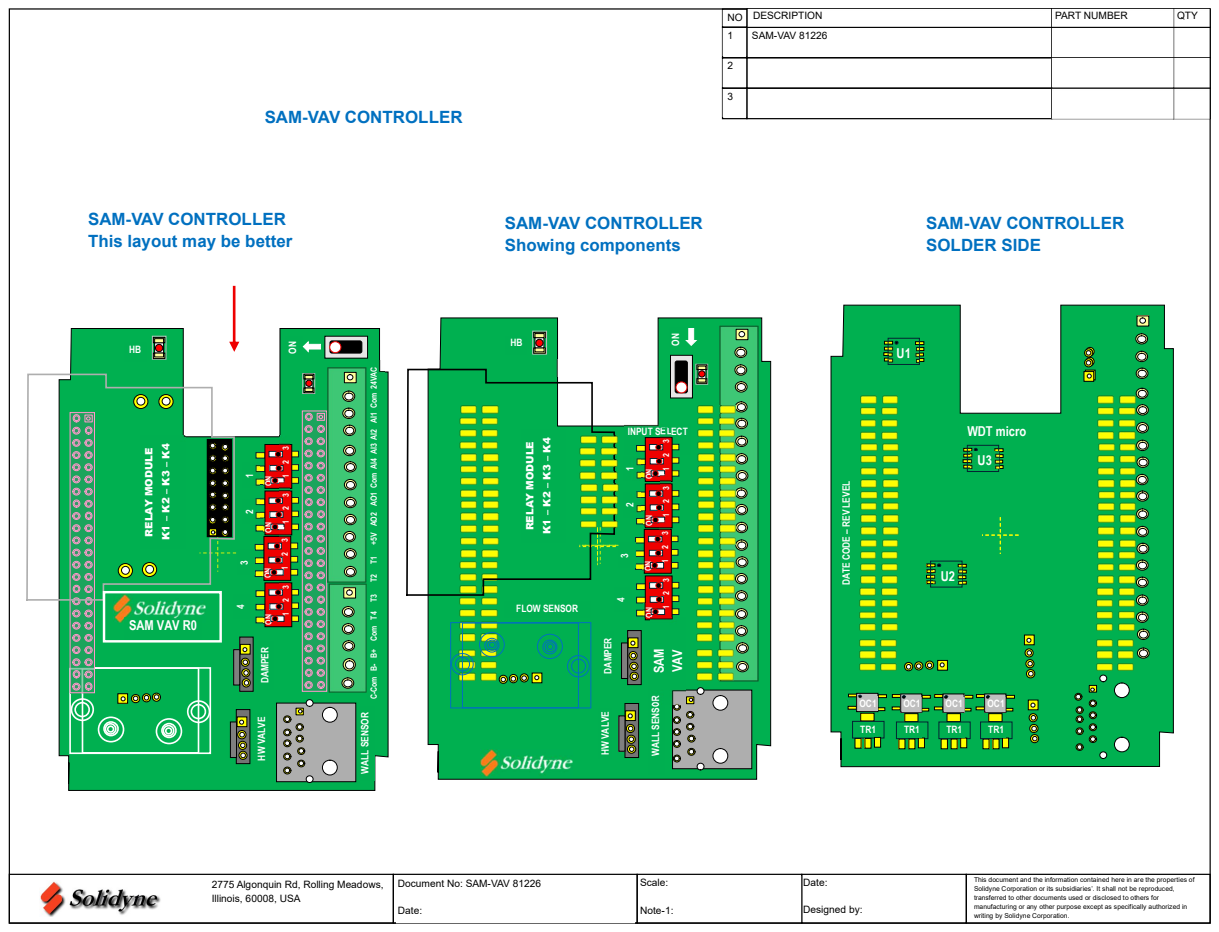
[picture p88: page 1]
Illinois, 60008, USA; Document No: SAM-VAV 81226 Date:; Date: Designed by:; This layout may be better; WALL SENSOR; INPUT SELECT 1 2 3 ON; FLOW SENSOR RELAY MODULE K¹ ⁻ K² ⁻ K³ ⁻ K⁴; SAM VAV; WDT micro; TR1 OC1 DATE CODE ⁻ REV LEVEL; WALL SENSOR ON; SAM VAV R0

SAM-VAV CONTROLLER

Showing components

SOLDER SIDE

C-Com B- B+ Com T4 T3 T2 T1 +5V AO2 AO1 Com AI4 AI3 AI2 AI1 Com 24VAC 1 2 3 ON 1 2 3 ON 1 2 3 ON 1 2 3 ON

4 DAMPER HW VALVE RELAY MODULE K1 – K2 – K3 – K4

4 DAMPER HW VALVE

2775 Algonquin Rd, Rolling Meadows,

transferred to other documents used or disclosed to others for manufacturing or any other purpose except as specifically authorized in writing by Solidyne Corporation. Scale: Note-1:

This document and the information contained here in are the properties of Solidyne Corporation or its subsidiaries’. It shall not be reproduced,
