ZyntelliTech/Solidyne-SAM-BBG/layouts/SAM dimensions 8-19-26.pdf

``

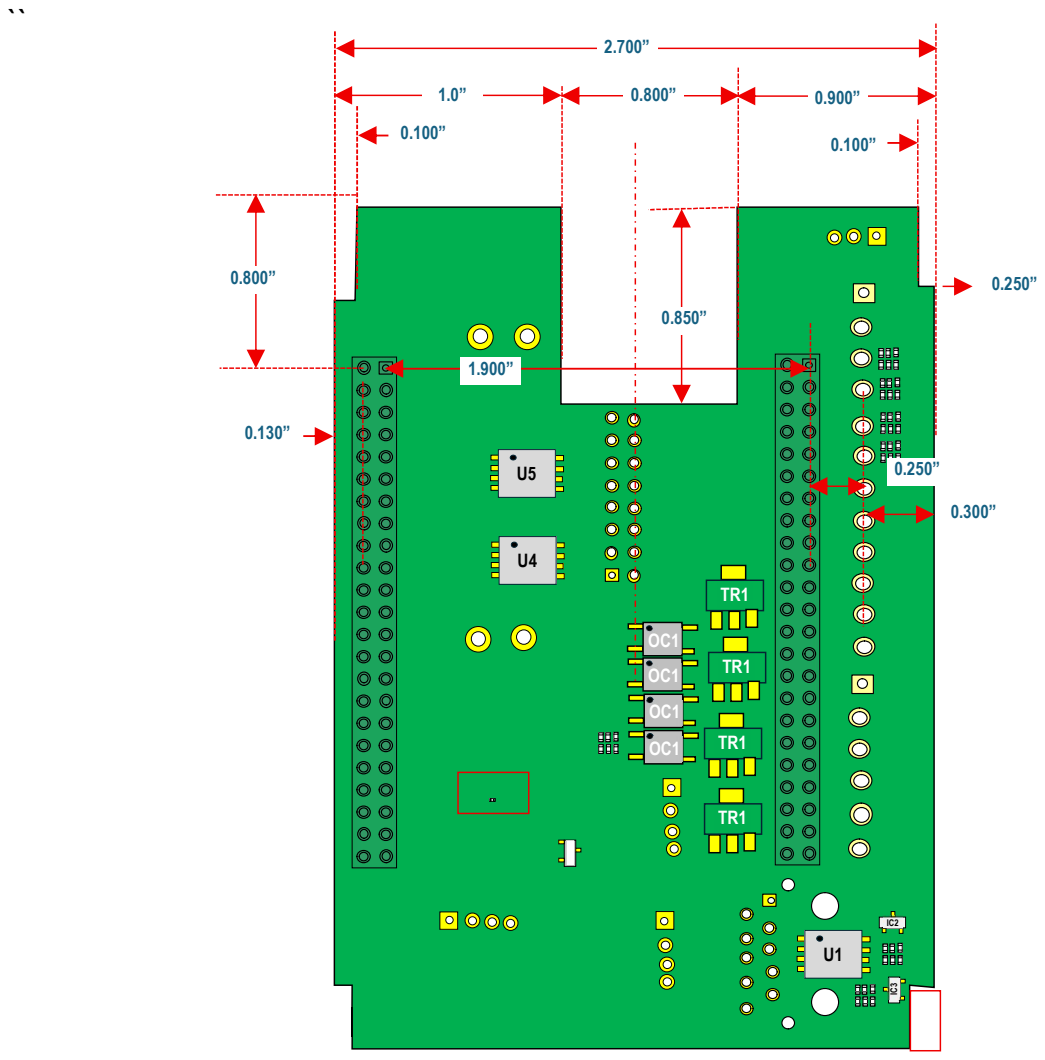
[picture p89: page 1]
IC2IC³
