ZyntelliTech/Solidyne-SAM-BBG/(list of files, drawings)

Other design files:
DAC.ms14
multisim/simulation.ms14
multisim/UniversalInput.ms14
SAM-2.eprj
