ZyntelliTech/Solidyne-SAM-BBG/WDT_SAM_Kicad/WDT_SAM.kicad_pcb

## KiCad design WDT_SAM_Kicad/WDT_SAM.kicad_pcb (2026-09-18)

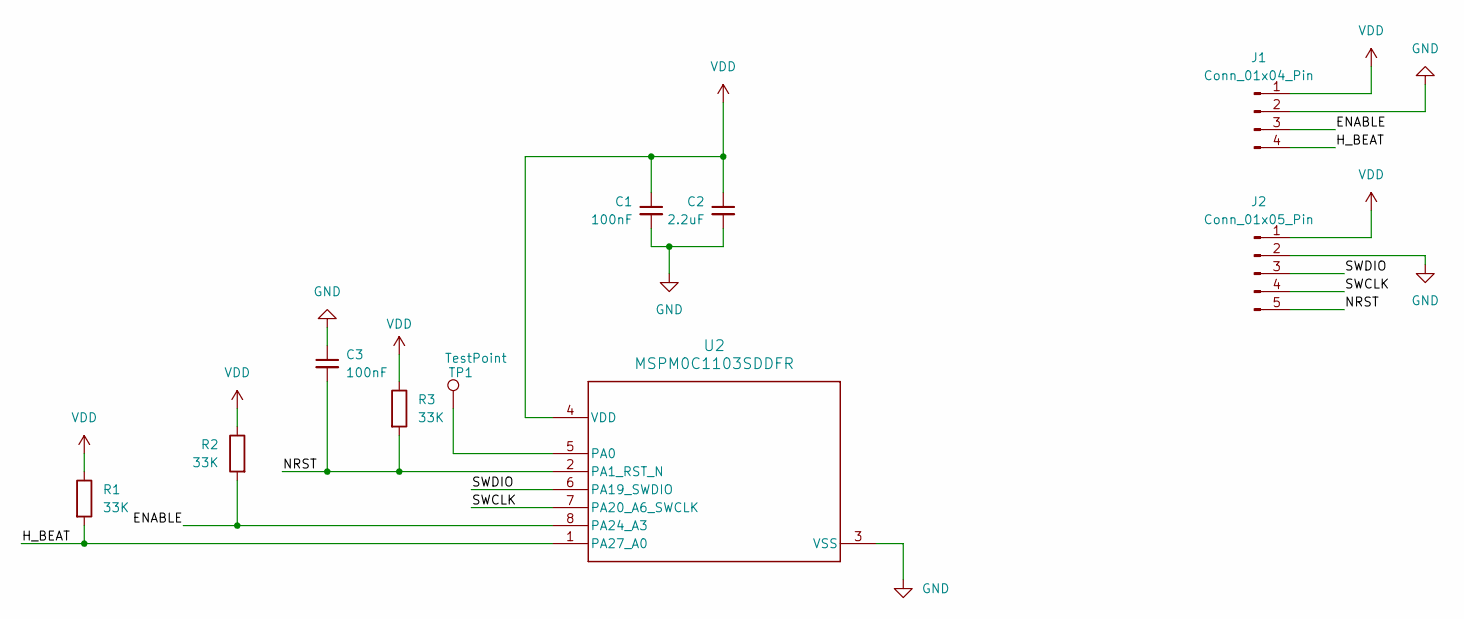
[picture p90: schematic WDT_SAM.kicad_sch]

Parts:
C1, C3: 100nF; C_0603_1608Metric_Pad1.08x0.95mm_HandSolder; JLC C1590
C2: 2.2uF; C_0603_1608Metric_Pad1.08x0.95mm_HandSolder; JLC C43922
J1: Conn_01x04_Pin; PinHeader_1x04_P2.54mm_Vertical
J2: Conn_01x05_Pin; PinHeader_1x05_P2.54mm_Vertical_SMD_Pin1Left; JLC C5160788
R1, R2, R3: 33K; R_0603_1608Metric_Pad0.98x0.95mm_HandSolder; JLC C4216
TP1: TestPoint; TestPoint_Pad_1.0x1.0mm
U2: MSPM0C1103SDDFR; DDF0008A-IPC_A; JLC C35962001

Connections:
/ENABLE: J1.3, R2.2, U2.8 (PA24_A3)
/H_BEAT: J1.4, R1.2, U2.1 (PA27_A0)
/NRST: C3.2, J2.5, R3.2, U2.2 (PA1_RST_N)
/SWCLK: J2.4, U2.7 (PA20_A6_SWCLK)
/SWDIO: J2.3, U2.6 (PA19_SWDIO)
GND: C1.2, C2.2, C3.1, J1.2, J2.2, U2.3 (VSS)
unnamed: TP1.1 (1_1), U2.5 (PA0)
VDD: C1.1, C2.1, J1.1, J2.1, R1.1, R2.1, R3.1, U2.4 (VDD)

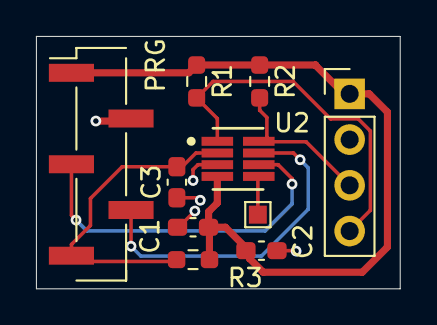
[picture p91: board WDT_SAM.kicad_pcb from above]

Board: 2 copper layers, 20.2 x 14.0 mm, 10 parts (0 on the bottom side), 8 nets.
