ZyntelliTech/Solidyne-SAM-BBG/(commit log)

2026-08-22 EasyEDA Project
    [BOM_Relay_Rev0.xlsx, DAC.ms14, PickAndPlace_Relay_Rev0.xlsx, SAM-2.eprj, UniversalInput.ms14, simulation.ms14]
2026-09-18 Finish SAM25 PCB layout
    [3D_RelayPCB.step, BOM_SAM-25_2026-09-18.xlsx, PickAndPlace_SAM-25_2026-09-18.xlsx, SAM-2.eprj, WDT_SAM.kicad_pcb, WDT_SAM.kicad_sch, WDT_SAM_bom.xlsx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]
2026-10-13 Finished SAM-VAV and SAM-25 PCB layouts
2026-10-27 Printed the latest schematic files
